Project-Liquid/TheRocket/RegenSolver/README.md

# Regen Solver
This folder contains everything related to the solver developed for the Yale Project Liquid Team. Key files are:
1. <em>hemsolver.ipynb</em> - the main (HEM Model) solver
2. <em>solverscript.py</em> - a python script version of the solver

as well as some additional solver variations (with main differences related to coolant-property definition):

3. <em>subcomprsolver.ipynb</em> - a solver based on the main solver, but using properties for a coolant (using CoolProp) that is in the subcooled liquid state region
4. <em>subsupersolver.ipynb</em> - a solver based on the main solver, but using properties for a coolant (using Cantera) that is in the suberheated vapor state region

The main files to use, however are (1) and (2).

## Regen Solver Usage
There are 2 ways to use the main (HEM model) solver: 

1. the Jupyter Notebook version (hemsolver.ipynb) - a notebook version, which includes all the developed info with all the plots and explanations, but is slower to run (and requires a lot of scrolling).

2. the Python Script version (solverscript.py) - a python script version, that abstractizes all the logic and code of the solver (and is thus more difficult to interpret when starting out), but gives much more flexibility, faster solving and allows for iteration on variables.

The setup for both of these versions is very similar - the main difference is in the reccommended IDE’s used. The following discussion will be only on the Notebook version.

#### Setup
To run the code, one needs to install the following aditional libraries:
- scipy
- CoolProp
- cantera
Our package import looks like this
```
# general
import os
import numpy as np
import pandas as pd

# thermo and prop
import cantera as ct
from CoolProp.CoolProp import PropsSI

# numerical methods
import scipy.optimize

# visualization / other
import matplotlib.pyplot as plt
```

#### Usage

<b>Prereqs:</b>
For the notebook version the recommended IDE is VSCode. Note: to run .ipynb files you will need to install some additional extensions if you don’t already have them. VSCode is nice in that it recommends you these extensions you need, but for safety one you definitely need is the Jupyter extension which you can install by going to Extenstions an finding it in the search bar.

<b>Usage:</b>
To use this version, define your solver input parameters located at the very top and then click the Run All button on the top toolbar. All the results will be outputed and visible by scrolling to the very bottom of the solver notebook.

#### Parameter definition
Parameter definition in <em>hemsolver.ipynb</em> looks as follows:
```
# Define Parameters
def_P0 = 2.758e+6 # [Pa] - first chamber (stagnation) pressure guess 
def_Ti = 300      # [K] - first chamber inlet temperature guess
def_P_ci = 4.5e+6 # [Pa] - coolant inlet pressure
def_X_ci = 0.4 # [-] - coolant inlet quality
def_x_off = 0.024 # [m] - cooling jacket offset
def_T_hw = 1000 # [K] - target hot wall temperature (should be below 1373 K)
def_T_cw = 530 # [K] - target cold wall temperature (should be below 623 K)
def_N_channels = 16 # [-] - number of cooling channels
def_t_rib = 0.005 # [m] thickness of ribs 
def_k_wall = 30 # [W/mK] - thermal conductivity of wall
def_N = 100 # number of nodes
```
Changing any one of these parameters will change the output. More parameters are definable (such as defining target temperatures as piee-wise linear functions), but it is suggested to refer to the solver file itself for explanations on them.

## Some Example Results
Here are examples of plots from the solver. Note that these do not depict the actual potential design, yet they do serve to display the format of the visual outputs of the solver.

<b>Coolant Pressure:</b>
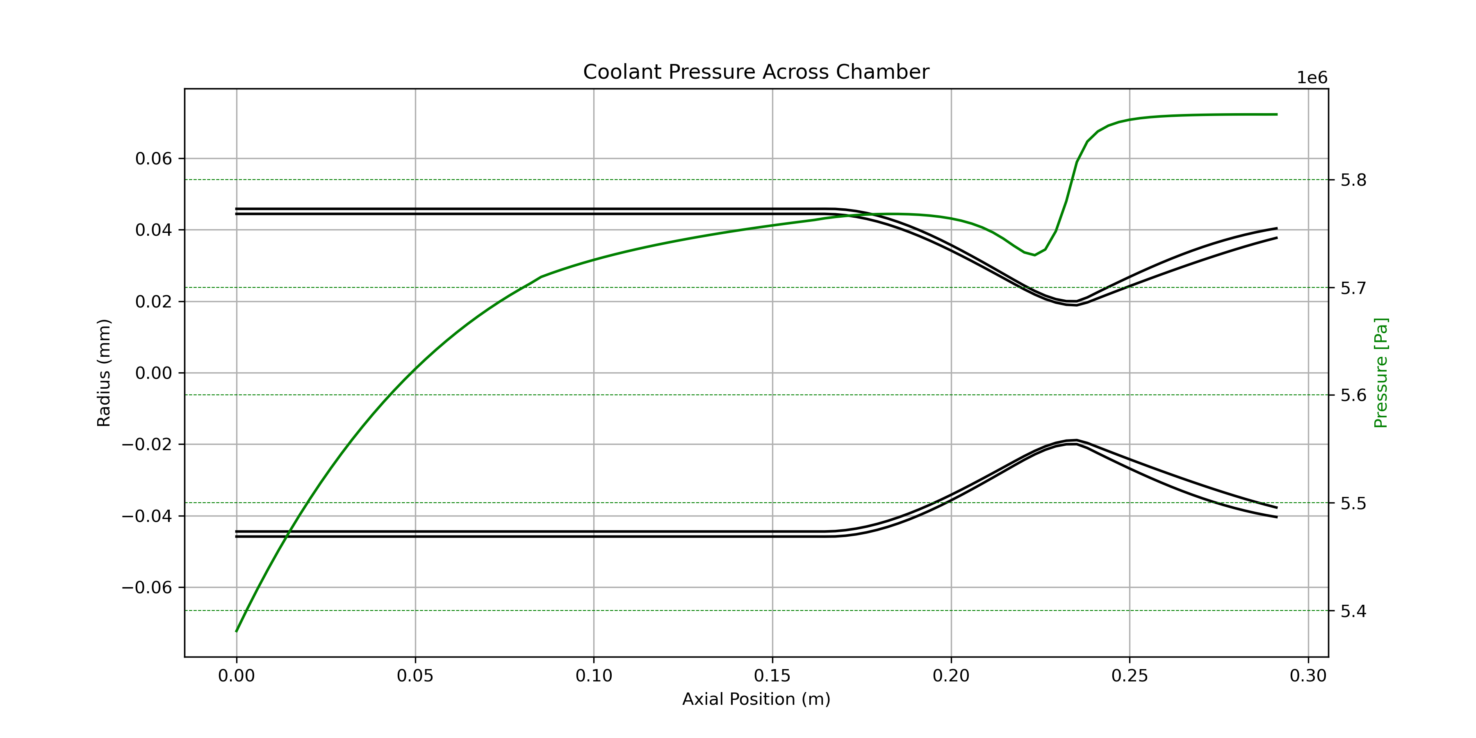
[picture p1: RegenSolver/solverplots/solved/coolantpres.png]
Pressure


<b>Coolant Temperature:</b>
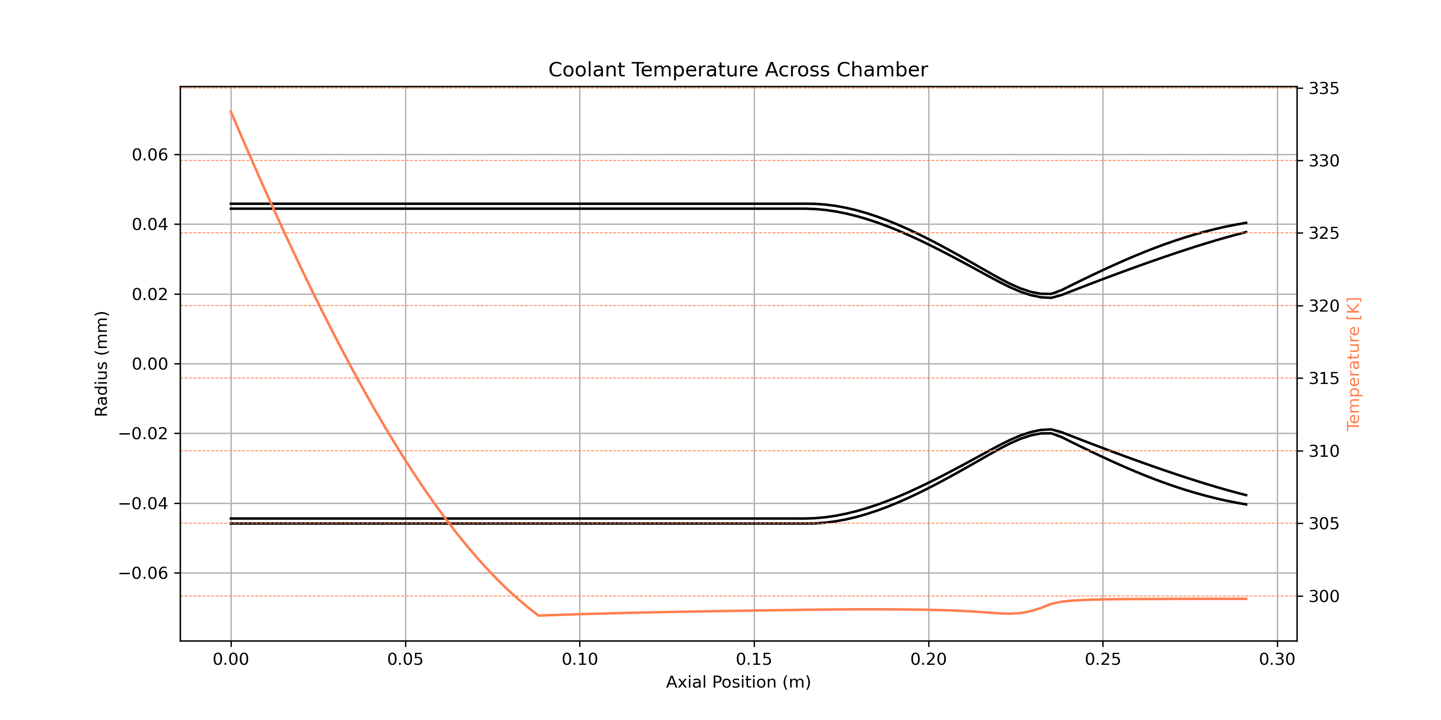
[picture p2: RegenSolver/solverplots/solved/coolanttemp.png]
Temperature


<b>Coolant Velocity:</b>
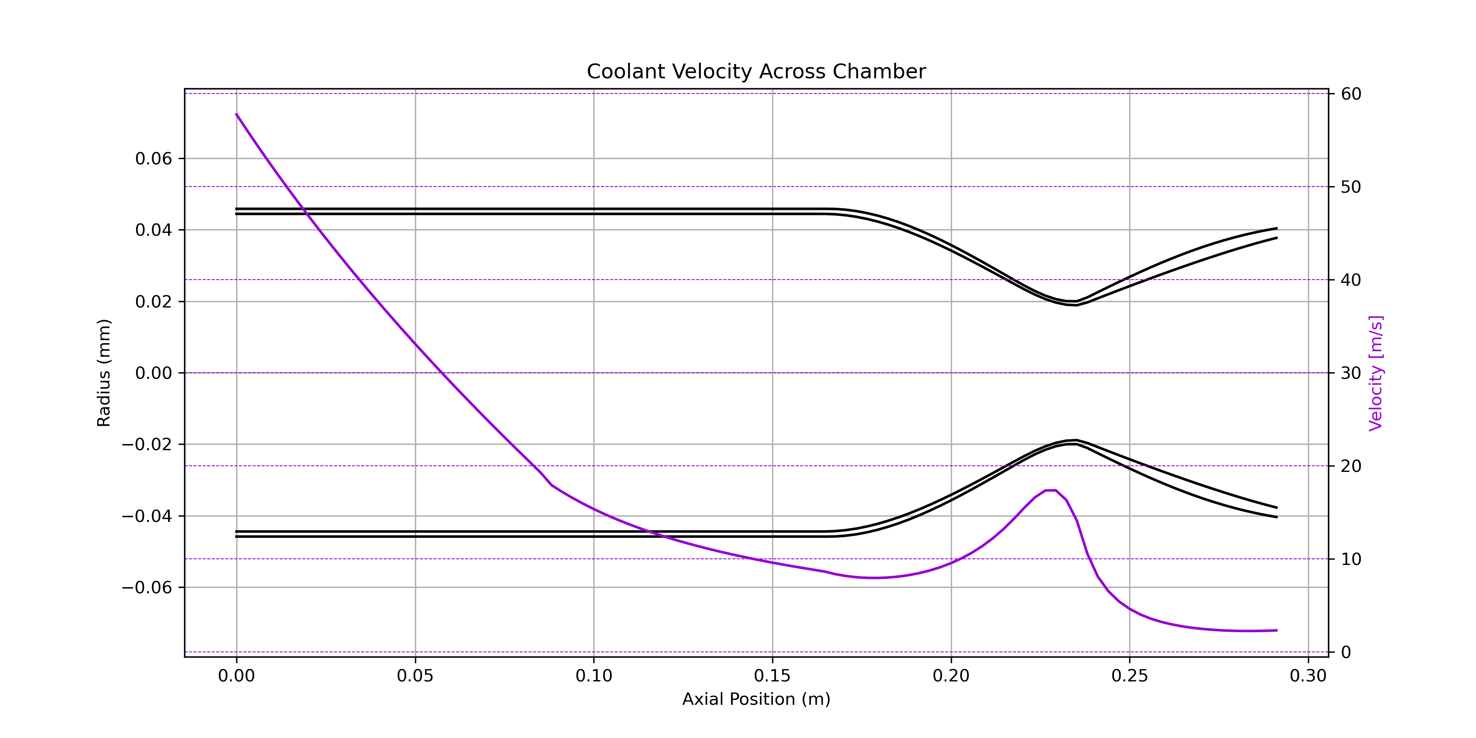
[picture p3: RegenSolver/solverplots/solved/coolantvel.png]
Velocity


<b>Coolant Density:</b>
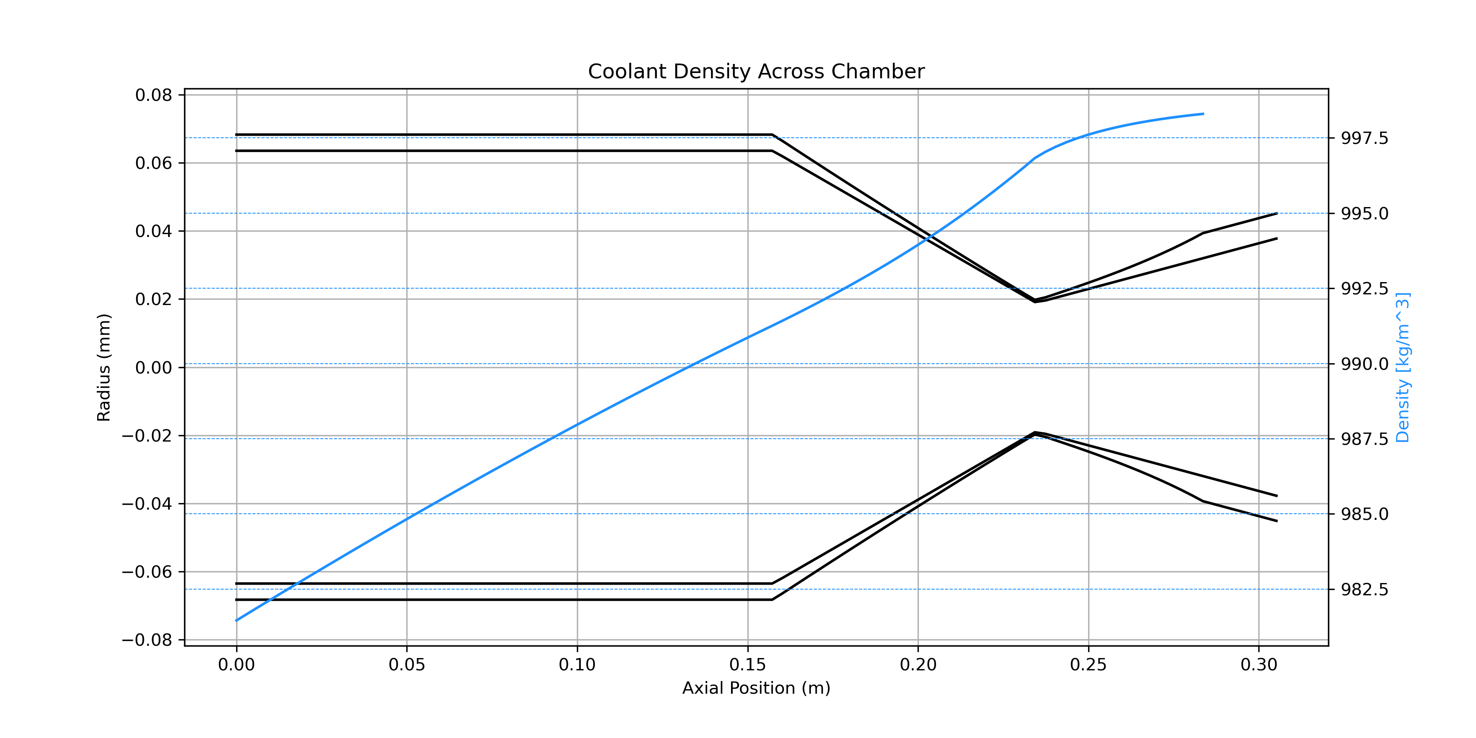
[picture p4: RegenSolver/solverplots/solved/soldens.png]
Density
