Project-Liquid/TheRocket/TheEngine/Thermal Considerations & Film Cooling/Gaseous Boundary Layer Cooling.docx

# Gaseous Boundary Layer Cooling Modeling

Last Updated: 9/12/2022

## Boundary Layer Cooling Principles

Boundary layer cooling is a very simple and effective method of cooling the combustion chamber walls of a rocket. The basic idea is that the freestream working fluid is separated from the wall by the coolant-filled boundary layer. The heat from the working fluid then must convect through the boundary layer, which then in turn convects heat into the chamber wall. As the coolant travels downstream, more and more heat convects into the coolant - so the average temperature throughout the boundary layer increases with axial distance downstream. This, in turn, means that boundary layer cooling is less effective as you go further downstream. Below in figure 1 is a qualitative example of a curve of cooled wall temperature over axial distance.

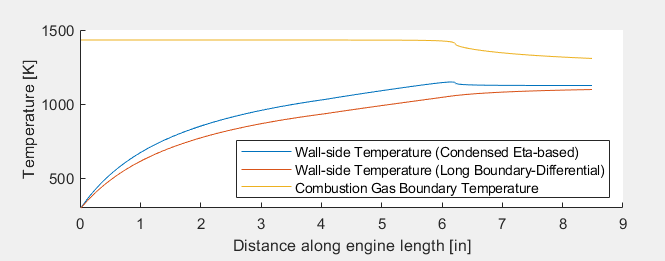
[picture p7: figure]

Figure 1: Qualitative Example of Cooled Wall Temperature vs Axial Distance

When designing a liquid rocket engine, the most important thermal parameter is the heat flow or heat flux into the engine, one of the parameters of which is the temperature of the gas contacting the wall. Therefore, it is critical to determine the wall-side gas temperature, or adiabatic wall temperature, in combination with the heat transfer coefficient (see document [A], heat transfer coefficient section).

## Expanded Numerical Modeling of Wall-Gas Temperature

For the purposes of this project, the boundary layer coolant can be considered a gas upon injection, due primarily to ethane’s high vapor pressure and to a somewhat lesser extent the high freestream temperatures within the combustion chamber. This rather drastically reduces the performance of the boundary layer coolant, but at least makes modeling of the effects of cooling somewhat simpler. An outline of a numerical model can be found in the air force technical report AEDC-TR-91-1 by William Grissom[1].

For this method, certain nomenclatures must be defined. They are listed below:

- G is the freestream mass flow rate per unit area, or mass flux in kg/s-m^2
- K_t is a turbulence correction factor, unitless, where K_t =1+10.2e_t
  - e_t is some scalar turbulence fraction, usually ~0.1
- m_(bl) is the total mass flow rate of the boundary layer at some point per unit circumference of the nozzle at the considered point in kg/s-m
- m_c is the coolant mass flow rate per unit circumference in kg/s-m
- D is instantaneous chamber diameter, in m
- T_(aw) is the adiabatic wall temperature at some axial distance in K
- T_s is the static freestream temperature in K
- T_r is the recovery temperature, or boundary layer side chamber temperature in K

Grissom then outlines step-by-step a method for predicting the adiabatic wall temperature across the length of the nozzle. While they are provided in the form of differential equations (e.g. dM = f(x)dx ), if variables such as, for example, dM are treated as finite values (i.e. treat dM as ΔM ) and broken into many finite step sizes, the problem becomes similar to a higher-order application of Euler’s method. The equations which drive such a model are outlined below.

First, initial conditions must be set, and correction factors calculated. They are as follows:

Initial diameter: D = D_c

Initial circumferential coolant flow rate: MC_c =(m_(BLC))/(πD)

Initial boundary layer flow rate: MC_(bl) =MC_c

Initial wall temperature: T_(aw) =T_0

Molar weight correction factor: K_m =((M_c)/(M_g))^0.14

Turbulence correction factor: K_t =1 + 10.2e_t

Begin at some point of distance L downstream. In this case, we will begin at L = h , where h is the step size, in meters, such that across each step the finite distance dL≈h .

First, calculate the change in diameter at that point. This can be done using downstream distance of the nozzle inlet, or the beginning of the converging section, L_(con) , that of the throat, L^(*) , and that of the end of the nozzle, L_(exit) , as well as the angle of contraction θ_(con) and expansion θ_(exp) . Save the finite stepwise change in diameter as dD as follows:

dD = D_i -D_(i-1) (1)

Then, the discrete value of dx can be calculated where x is the distance parallel to the contour.

dx = √(dL^2 +dr^2)=√(dL^2 +((dD)/2)^2) (2)

Contour distance x is then calculated simply:

x_i = x_(i-1) +dx (3)

Current flow area is calculated using the diameter:

A_i =1/4πD^2 (4)

Freestream mass flux is calculated using the area and given constant freestream mass flow rate:

G_i = (m_(fs))/(A_i) (5)

Freestream mach number is then calculated using methods outlined in the nozzle flow modeling document[B]. Next, the properties of both the coolant and the freestream gas must be retrieved. The only practical way to do so is to use software, preferably Cantera, as outlined in the Quick Reference document[C], after setting the respective gasses to their static conditions. Specifically, the isobaric heat capacity c_p , dynamic viscosity μ , and thermal conductivity k must be obtained for both the coolant gas/fuel and the freestream product gas. Following this, the prandtl number can be calculated as per its definition:

Pr_(fs, i) =(μ_(fs, i) c_(p, fs, i))/(k_(fs, i)) (6)

Pr_(c, i) =(μ_(c, i) c_(p, c, i))/(k_(c, i)) (7)

Next, a second-order Runge-Kutta method is employed to approximate the addition of mass flow rate to the boundary layer from entrainment of the freestream gas in the boundary layer. The finer details of the method will be spared, but the vague framework of the method is that a guess will be made at the change in boundary layer mass flow, after which a new guess will be made based on the first guess, and then the final guess is approximated as the average of the two.

dMC_(bl, fse, i, 1) =0.1963K_t G_i ((μ_(fs, i))/(MC_(bl, i)))^0.25 dx (8)

dMC_(bl, fse, i, 2) =0.1963K_t G_t ((μ_(fs, i))/(MC_(bl, fse, i) +dMC_(bl, fse, i, 1)))^0.25 dx (9)

…noting again that dMC and dx are treated as finite, scalar values for this method, and that equation 9 has the output from equation 8 as a parameter. The actual delta-mass flow is then approximated as an average of the two guesses.

dMC_(bl, fse, i) =(dMC_(bl, fse, i, 1) +dMC_(bl, fse, i, 2))/2 (10)

Next, the change in coolant mass flow per unit circumference due to the changing diameter of the nozzle across axial distance - i.e. the decreasing/increasing circumference - must be calculated. This can be approximated using the following equation:

dMC_(c, D) = -(MC_(bl, i))/(D_i)dD (11)

…with dD again being treated as a finite delta-D. The change in the total boundary layer mass flow rate can then be approximated by simply adding the “delta-MC” terms calculated above, like so:

MC_(bl, i) =MC_(bl, i-1) +dMC_(bl, fse, i) + dMC_(c, D, i) (12)

…and the change in coolant (not total boundary layer) mass flow rate per unit circumference can be approximated by neglecting the free stream gas entrainment:

MC_(c, i) =MC_(c, i-1) +dMC_(c, D, i) (13)

Next, the recovery temperature, or the temperature of the freestream gas after contacting the boundary layer, must be calculated. The recovery temperature is simply a function of the stagnation temperature T_0 (assumed to be essentially equal to chamber temperature as per the chamber modeling document[D]), Prandtl number, and the static temperature T_s as calculated throughout the nozzle in the nozzle modeling document[B].

T_r =T_0 -(1-Pr_(fs) ^(1/3) )(T_0 -T_s ) (14)

Finally, the linearized change in adiabatic wall temperature can be approximated using the provided equation:

dT_(aw, i) = dMC_(fse, i) (Tr-T_(aw, i-1) )(MC_(bl, i) +MC_(c, i) (1/(K_m)*(c_(p, c))/(c_(p, fs))-1))^(-1) (15)

Then, approximating the adiabatic wall temperature at the current step simply becomes:

T_(aw, i) =T_(aw, i-1) +dT_(aw, i) (16)

For the purposes of determining heat flux, the heat transfer coefficient can be calculated as per the thermal loads document[A]. This process then restarts, with the calculated parameters in equations 3-16 becoming the initial conditions for the next step. The process is repeated for each step until the full length of the nozzle has been covered. Note that after the recovery temperature, wall temperature, static pressure[D], etc. are calculated at each point, the fluid properties of the coolant and freestream gas must be re-evaluated - again, preferably using Cantera.

## Single Differential Modeling of Wall-Gas Temperature

The previous purely numerical method can be used to yield marginally more conservative (i.e. higher temperature) estimates of an expected wall temperature, another method is provided by Grissom which appears to yield curves which more closely reflect the effects of changing recovery temperature throughout the nozzle. This method involves a single differential equation describing the behavior of the cooling effectiveness η . The cooling effectiveness is defined simply as…

η=(T_r -T_(aw))/(T_r -T_0) (17)

…or more simply put, the ratio of the difference between the recovery temperature T_r and the wall temperature T_(aw) to the difference between the recovery temperature T_r and the injection temperature T_0 . So, when η=1 , the wall temperature is equal to the injection temperature (i.e. no heat flow from the freestream into the wall), and when η=0 the wall temperature is equal to the recovery temperature (i.e. no cooling).

This method is centered around the following differential equation describing η as a function of contour distance x :

dη= -0.1963K_i *K_T *K_m (c_(p, fs))/(c_(p, c))η^2 (1+(1/(K_m)*(c_(p, c))/(c_(p,) fs)))(1/η-1)^(-1/4) dx (18)

The only difference in the initial conditions and nomenclature are defined as follows:

Initial film cooling effectiveness: η= 1

General correction factor: K_i =(G_i μ_(fs) ^0.25)/(MC_c ^1.25)

Parameters such as D , μ , G , K_t , and K_m can be calculated in the same manner as specified in the above section. dx is calculated as a finite value in the same manner, using equation 2. Recovery temperature T_r is again calculated using equation 14.

Assuming an initial cooling effectiveness of η=1 , equation 18 is then used to calculate some finite dη at each point of axial distance L_i starting at L_(i=1) . The cooling effectiveness at each point i can then be determined using a similar method as equation 16, shown below in equation 19.

η_i =η_(i-1) +dη_i (19)

Once discrete values of η have been obtained, the wall temperature T_(aw) can then be backed out simply by using the definition of boundary layer cooling effectiveness, equation 17.

T_(aw, i) =T_(r, i) -η_i (T_(r, i) -T_0 ) (20)

This method is somewhat computationally simpler to implement, and yields a curve which more closely resembles the experimental data shown in TR-91-1[1], but can be more optimistic in its predictions of the effectiveness of film cooling, albeit to a very small degree. As with the expanded method, the coolant ideal gas properties such as density and viscosity need to be recalculated at the calculated static pressures and wall temperatures/recovery temperatures.

Comparisons of these two methods indicate that the predicted wall temperature does not differ significantly until the flow reaches the expanding section of the nozzle, after which the temperature predicted by the single-equation method decreases very slightly below that of the expanded method. Determining which method is more accurate to experimental results, however, requires testing of the rocket engine itself for comparison to theoretical data.

## References and Sources

[1] Grissom BL Cooling (https://drive.google.com/file/d/1sblwUi_BpPOf-dg0ytU-u0OWHGKqjmZC/view?usp=sharing)

## Related Documentation

[A] Thermal Considerations and Loads (https://docs.google.com/document/d/1homPFQnGbIEBKH1nYHeWbC9jdXok5Kiczb4tmeqo9O4/edit#)

[B] Nozzle Flow Modeling (https://docs.google.com/document/d/16WyGRw5Ikb9o1UvMvrIiOay80P_ZhJnjGX2SzdEGsrk/edit?usp=sharing)

[C] Cantera Quick Reference (https://docs.google.com/document/d/1qyf48IUYjvoWwlnIdurIilh9O9bYv-0zfA_flUvgOP8/edit?usp=sharing)

[D] Chamber Flow Modeling (https://docs.google.com/document/d/1jLYpAgBIF4DAZvxFLMegq2dOw-f8xS7uXNU71RqToM4/edit)
