Project-Liquid/TheRocket/TheEngine/Thermochemistry/Basics of Combustion.docx

# Principles of Nitrous Oxide-Ethane Combustion

Last Updated: 2/16/2022

## Perfect Combustion Reaction of Nitrous Oxide and Ethane

Not accounting for chemical equilibrium in imperfect combustion, the perfect combustion formula for nitrous oxide and ethane is expressed as the following formula:

2C_2 H_6 + 14N_2 O → 4CO_2 + 6H_2 O + 14N_2

Using this formula and the second chapter of An Introduction to Combustion[1] (pages 9-27) a value of temperature increase ΔT can be retrieved using the thermochemical properties available from either the CoolProp MATLAB wrapper[A] or the thermochemical tables available at the end of Intro to Combustion.

## Enthalpy of Reaction

To summarize the Enthalpy of Combustion section of Chapter 2[1], the heat of reaction (or ΔH_(rxn) ) can be expressed in the general form:

ΔH_(rxn) =ΣΔH_(f,reac) -ΣΔH_(f,prod) (1)

Where:

- ΔH is the total change in enthalpy for the given amount of products and reactants in moles

- ΔH_(f,reac) is the molar standard enthalpy of formation of the reactants

- ΔH_(f,prod) is the molar standard enthalpy of formation of the products

From this, the exhaust molar specific change in enthalpy Δh can be expressed generally as

Δh = (ΔH_(rxn))/(Σ(N_i MW_i )) (2)

Where:

- N_i is the stoichiometric coefficient of an exhaust product i

- MW_i is the molar weight in kg/mol of an exhaust product i

For our perfect combustion formula of ethane and nitrous oxide, these two equations become:

ΔH_(rxn, NOE) =ΣΔH_(f,reac) -ΣΔH_(f,prod)

= 2(ΔH_(f,Eth) ) + 14(ΔH_(f,N2O) ) - 4(ΔH_(f,CO2) ) -6(ΔH_(f,H2O) ) -14(ΔH_(f,N2) ) (3)

Note that ΔH_(f,N2) is 0 since it is a diatomic gas

## Adiabatic Flame Temperature

The generalized form for ΔT for a given ΔH_(rxn) is as follows:

ΔH =C_(p,ex) ΔT (4)

Where:

- ΔH is the change in gas enthalpy due to the reaction

- C_p is the total heat capacity of the exhaust products

- ΔT is the change in temperature from the initial to final temperature

Note that the value of C_(p,ex) must be obtained as C_p =ΣN_i c_(p,i) , or the sum of the stoichiometric coefficient of each species times its respective molar specific heat capacity at the approximate midpoint of between the initial temperature T0 and final temperature Tf. For our purposes, this Tmid can be assumed to be around 1500K ([1], pg 33).

So, expressing in terms of T_0 and T_f and the perfect N2O-Ethane combustion reaction:

T_f -T_0 = (ΔH_(cmb))/(C_(p,ex)) (5)

For perfect combustion like this, the enthalpy of combustion ΔH_(cmb) is assumed to be roughly equal to the enthalpy of reaction ΔH_(rxn) . Plugging in Equation 4 for ΔH_(cmb) and expressing c_p as a molar weighted fraction of the c_(p,i) of each product yields:

T_f =T_0 + (2(ΔH_(f,Eth) ) + 14(ΔH_(f,N2O) ) - 4(ΔH_(f,CO2) ) -6(ΔH_(f,H2O) ))/(4(c_(p,CO2) ) + 6(c_(p,H2O) ) + 14(c_(p,N2) )) (6)

Pulling the enthalpies of formation from the Intro to Combustion appendix and getting the c_p of each species from CoolProp in MATLAB allows for the calculation of a perfect adiabatic flame temperature of a stoichiometric mixture (a theoretical maximum temperature).

## Flame Temperature with an Excess Propellant

The stoichiometric adiabatic flame temperature tends to be quite high - high enough to melt the engine or subject it to undue thermal stress (bar extreme cooling measures). So, our engine will be running fuel rich - more fuel will be injected into the combustion chamber than can be combusted by the amount of oxidizer available in the combustion chamber. This means that, again neglecting minor reaction products, the fuel will remain uncombusted and absorb some excess heat.

Typically, the mix ratio of fuel is given in terms of mass, usually the variable r, where r = (m^(∙) _(ox))/(m^(∙) _(fuel)) . For these purposes, however, a molar mix ratio r is ideal. This can be found using the ratio r=r(MW_(fu))/(MW_(ox))=(M_(ox))/(M_(fu)) .

Assuming that we will be running fuel rich under pretty much any circumstance (because running ox rich would cause the excess oxidizer to react with the steel in the engine), the combustion reaction can then be expressed as:

(14/r)C_2 H_6 + 14N_2 O → 4CO_2 + 6H_2 O + 14N_2 +(14/r-2)C_2 H_6

…where r≤7

In this case, the nitrous oxide can be assumed to be a constant since we’re assuming there will be excess fuel varying with a mixture ratio less than the stoichiometric mix ratio.

Plugging this new reaction back into Equation 6 yields:

T_f =T_0 + ((14/r)(ΔH_(f,Eth) ) + 14(ΔH_(f,N2O) ) - 4(ΔH_(f,CO2) ) -6(ΔH_(f,H2O) )-(14/r-2)(ΔH_(f,Eth) ))/(4(c_(p,CO2) ) + 6(c_(p,H2O) ) + 14(c_(p,N2) )+(14/r-2)(c_(p,C2H6) )) (7)

Again, assuming perfect combustion, this will allow for the calculation of adiabatic flame temperature as a continuous function of the molar mix ratio r up to a stoichiometric mix ratio of r=7 .

## Enthalpy of Vaporization

For any liquid at a given pressure, there is a certain amount of enthalpy (energy “input”) required to boil the liquid into a vapor. This enthalpy is referred to as the “enthalpy of vaporization”. This value is most often expressed in molar specific terms ( h_(vap) ) or mass specific terms ( h_(vap) ). In other words, h_(vap) is the amount of enthalpy required to vaporize a mole of water already at saturation pressure and temperature.

Most gasses in our exhaust products do not need to account for enthalpy absorbed by vaporization - water, however, may initially form as a liquid and absorb enthalpy until it becomes steam.

Assuming different levels of water vaporization immediately after combustion produces two possible values of heat produced: the “upper heating value”, in which it is assumed that no enthalpy is absorbed by water vaporization (i.e. ΣΔH = ΔH_(rxn) ), and the “lower heating value”, in which it is assumed that all the water absorbs all the theoretically possible enthalpy produced by vaporization. The lower heating value can be acquired by simply subtracting the number of moles of water times the molar specific enthalpy of vaporization of water at the given pressure (which can be retrieved from CoolProp), as in Equation 8.

ΔH_(low) =ΔH_(cmb) -N_(H2O) h_(H2O) (8)

In this case, for caution’s sake, we will be using the upper heating value to provide a worst-case estimate of the combustion temperature. Building an engine around an estimate of the temperature that is higher than the actual experimental temperature is safer than building one around a lower temperature

## Other Vaporization Considerations

Water is not the only fluid in this reaction which is expected to change phases. Both liquid propellants are stored relatively near their vapor pressure for our purposes, and once injected and subjected to the heat of the gas in the combustion chamber, will evaporate and absorb some amount of enthalpy. This means that regardless of our heating value, our propellants will evaporate and effectively lower our total enthalpy of reaction. Note that just as the molar enthalpy of vaporization of water can be found using CoolProp for water, so too can the enthalpy of vaporization be found for nitrous oxide and ethane.

Since in this case we are modeling combustion using a chemical formula, the enthalpy of combustion using the upper heating value including vaporization effects can be written as Equation 9.

ΔH_(cmb, high) = ΔH_(rxn) -N_(Nts) Δh_(vap,Nts) - N_(Eth) Δh_(vap,Eth) (9)

…and the enthalpy of combustion using the lower heating value can be expressed as in Equation 10.

ΔH_(cmb, high) = ΔH_(rxn) -N_(Nts) Δh_(vap,Nts) - N_(Eth) Δh_(vap,Eth) - N_(H2O) Δh_(vap,H2O) (10)

## References and Sources

[1] Introduction to Combustion (https://drive.google.com/file/d/1V93_c_ekuT-lM256LfNEVRspmNPMu8Vh/view?usp=sharing)

## Related Documentation

[A] CoolProp Quick Reference (https://docs.google.com/document/d/1SwY_JbAcMK3dY37hVzANKK0KHyNtMjkAvfUAsUOoy1Y/edit?usp=sharing)
