Project-Liquid/TheRocket/RegenSolver/canteraplots/canteravscoolprop.png

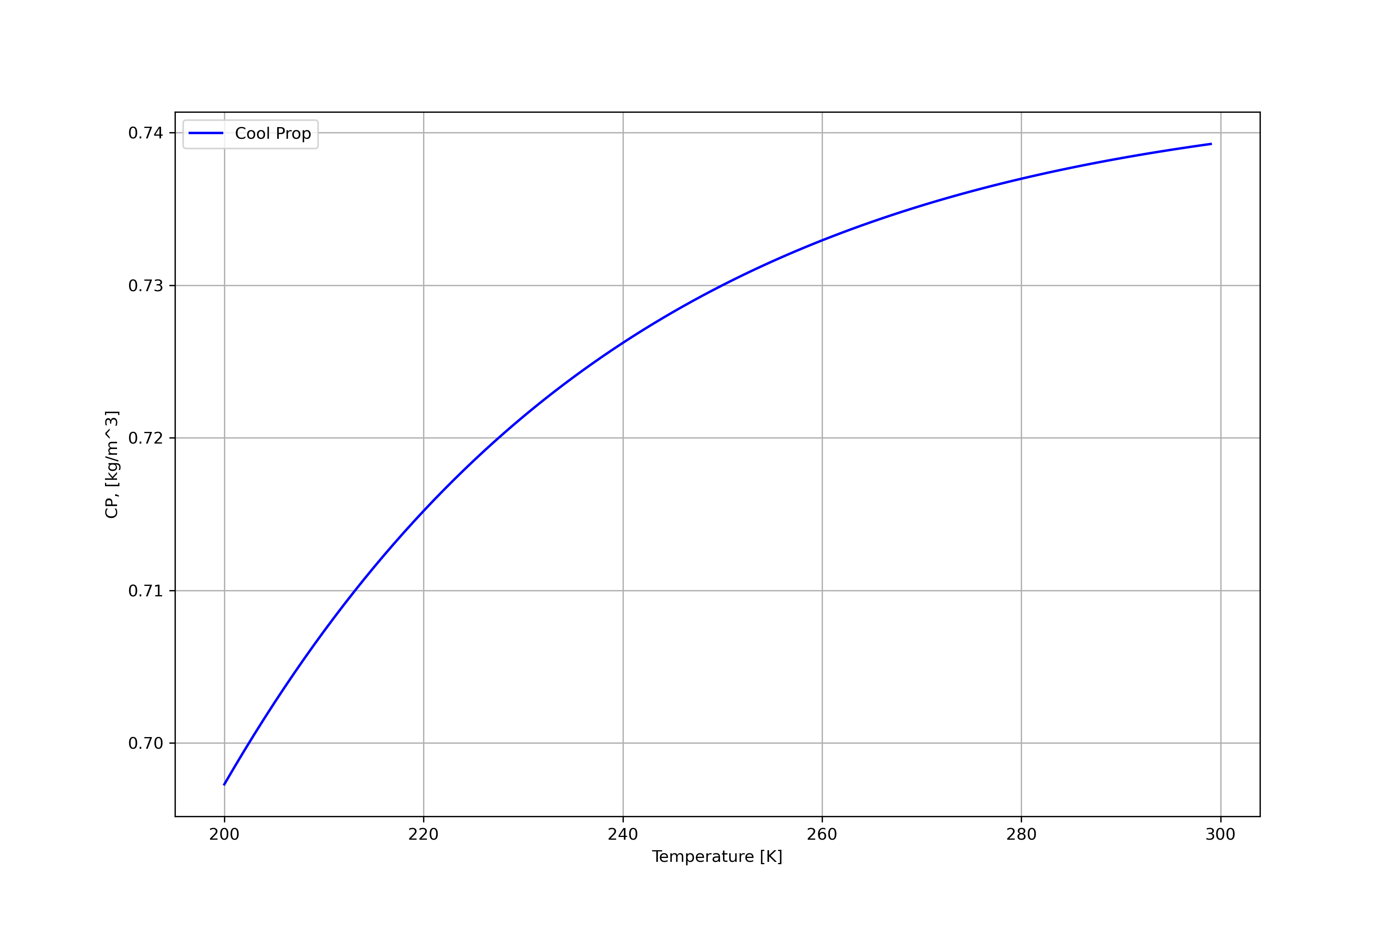
RegenSolver/canteraplots/canteravscoolprop.png
