Project-Liquid/TheRocket/RegenSolver/canteraplots/TvsOF.png

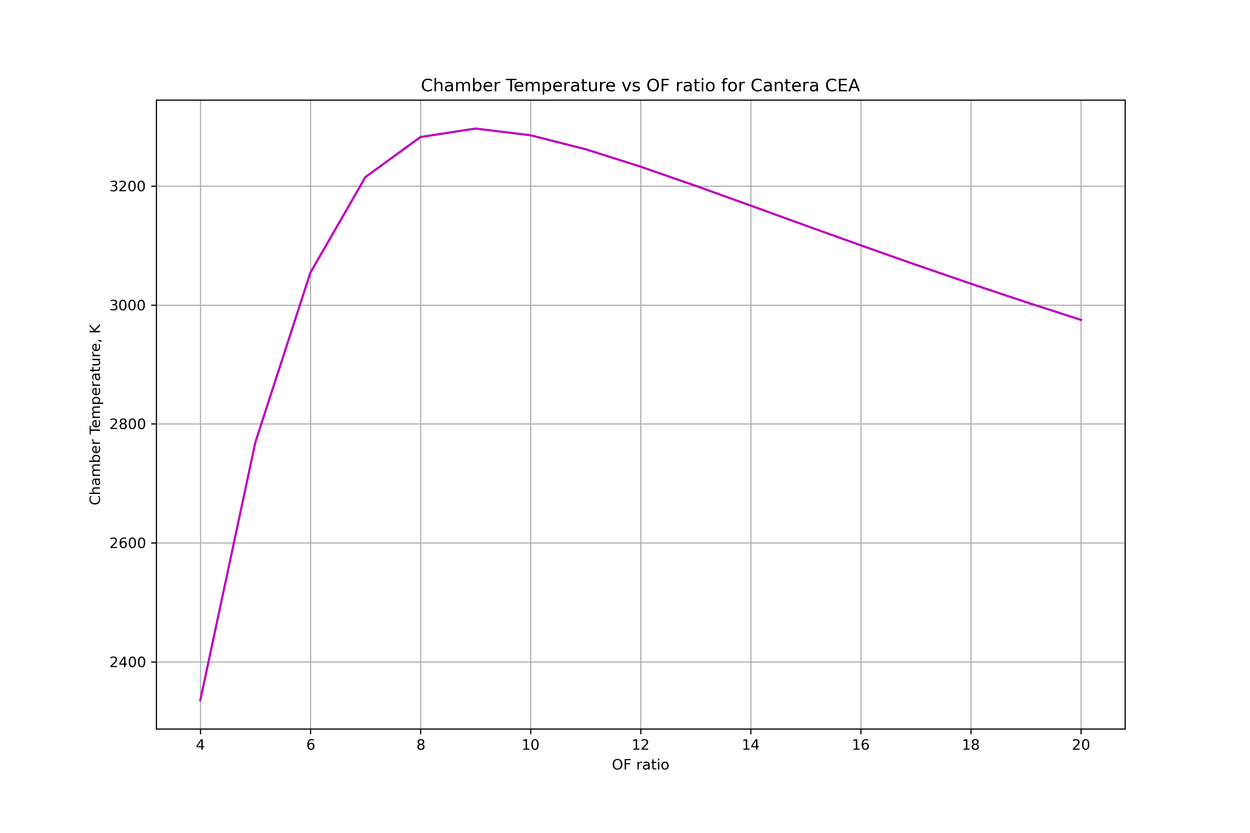
RegenSolver/canteraplots/TvsOF.png
