Project-Liquid/TheRocket/RegenSolver/engineplots/canteraenginegeometry.png

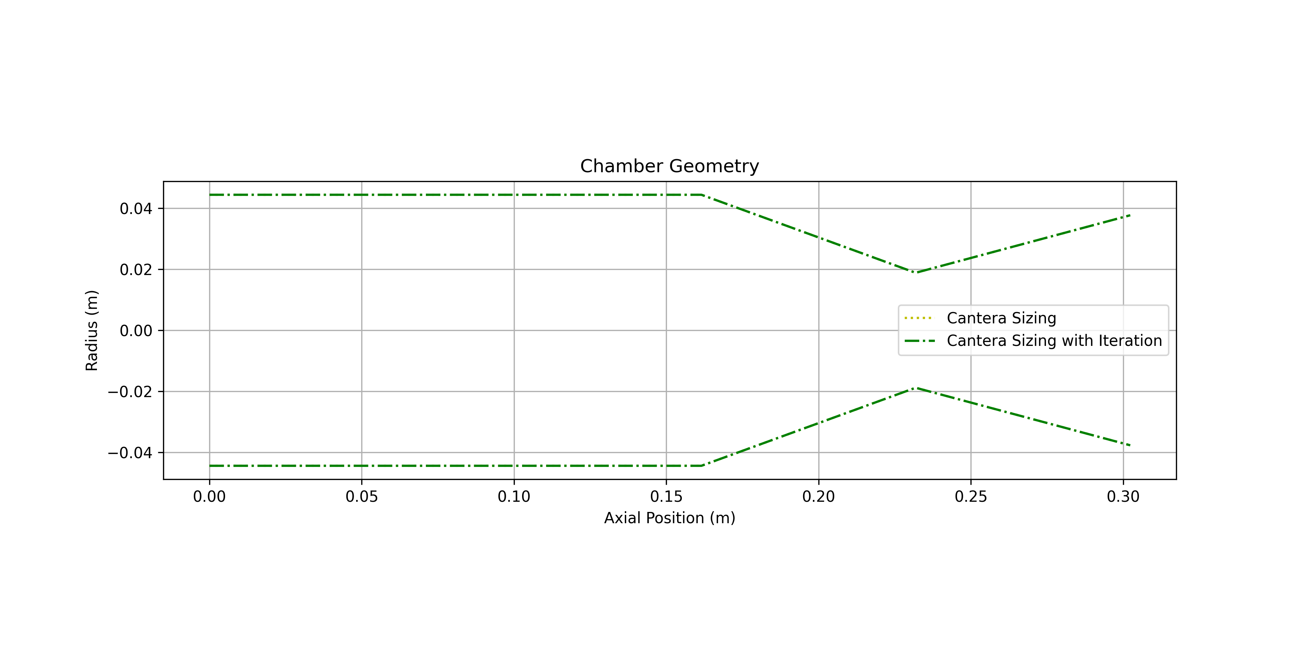
RegenSolver/engineplots/canteraenginegeometry.png
