Project-Liquid/TheRocket/RegenSolver/engineplots/enginegeometry.png

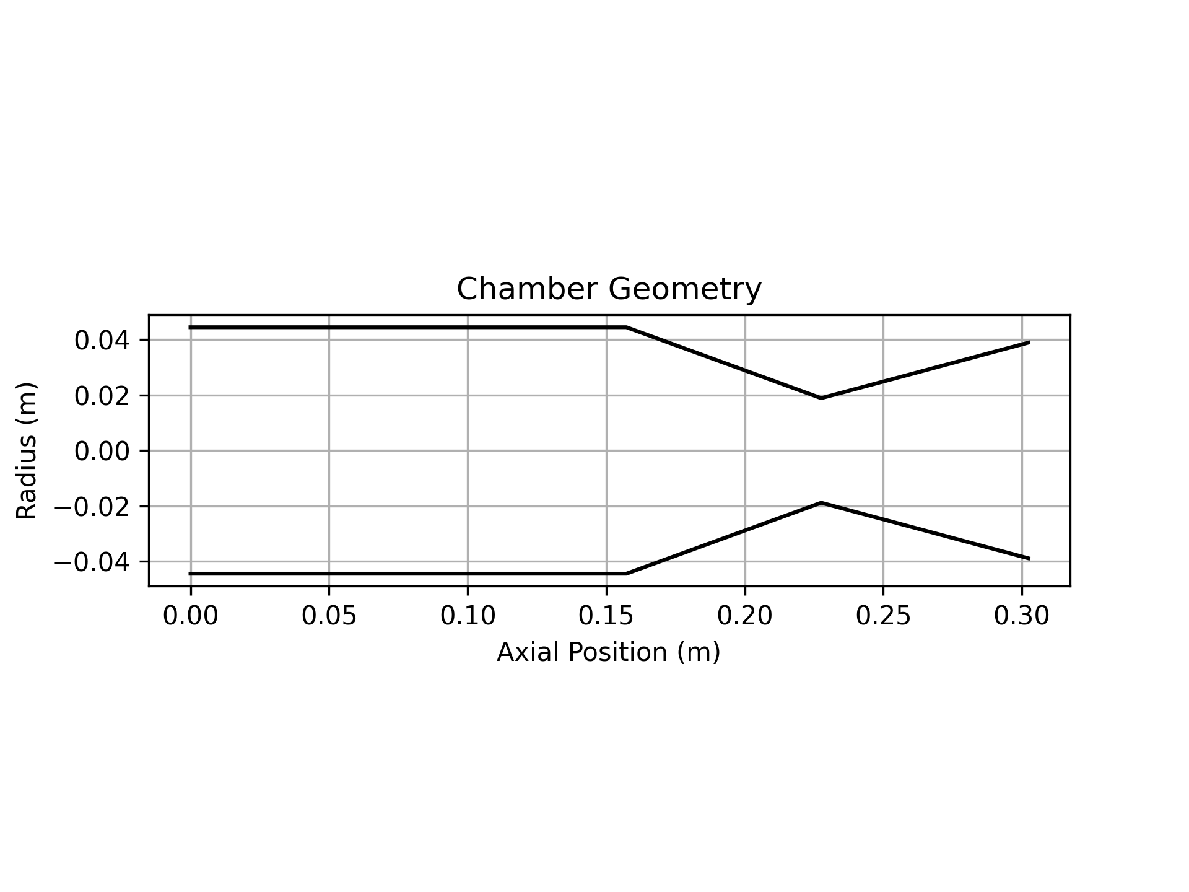
RegenSolver/engineplots/enginegeometry.png
