Project-Liquid/TheRocket/RegenSolver/solverplots/analysis/densityvsX_ci.png

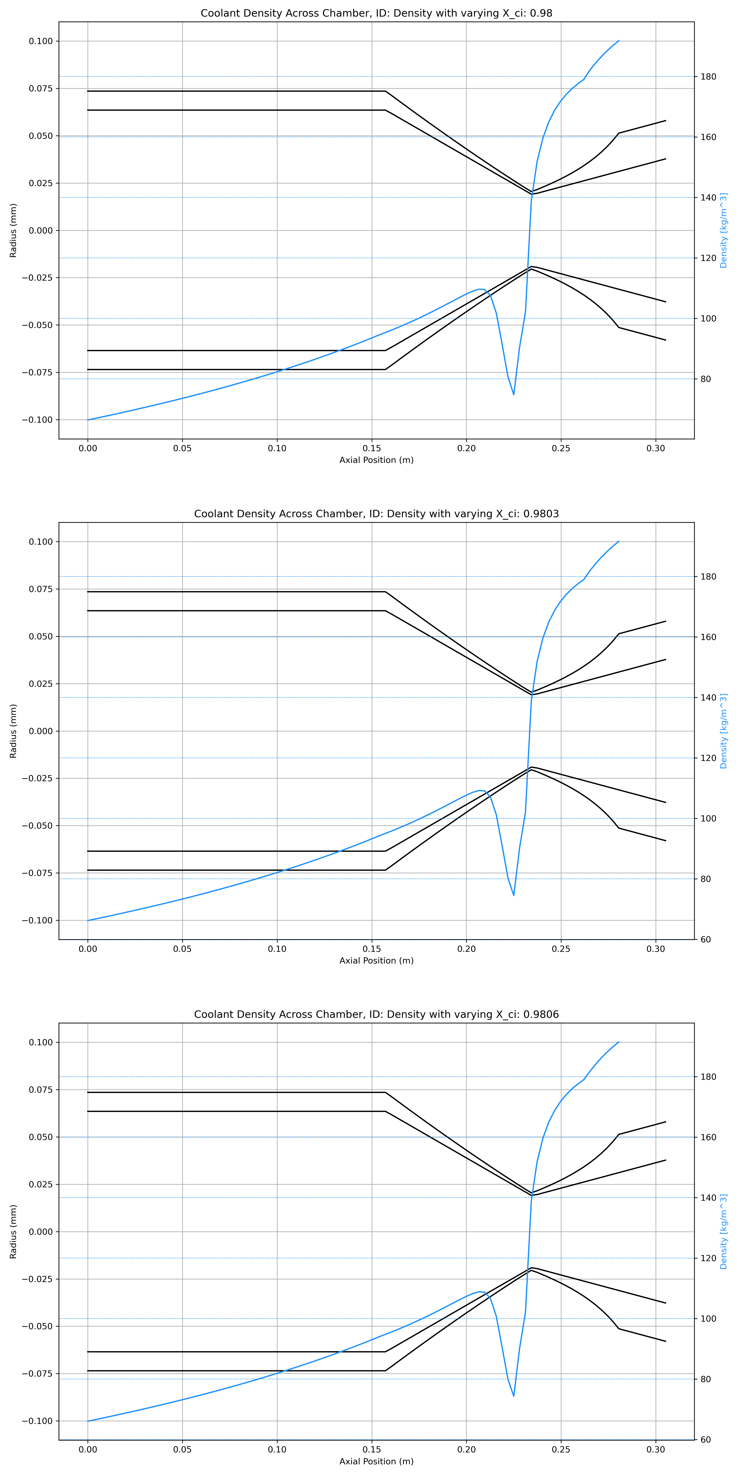
RegenSolver/solverplots/analysis/densityvsX_ci.png
