Project-Liquid/TheRocket/RegenSolver/solverplots/analysis/jacketvsN_chan.png

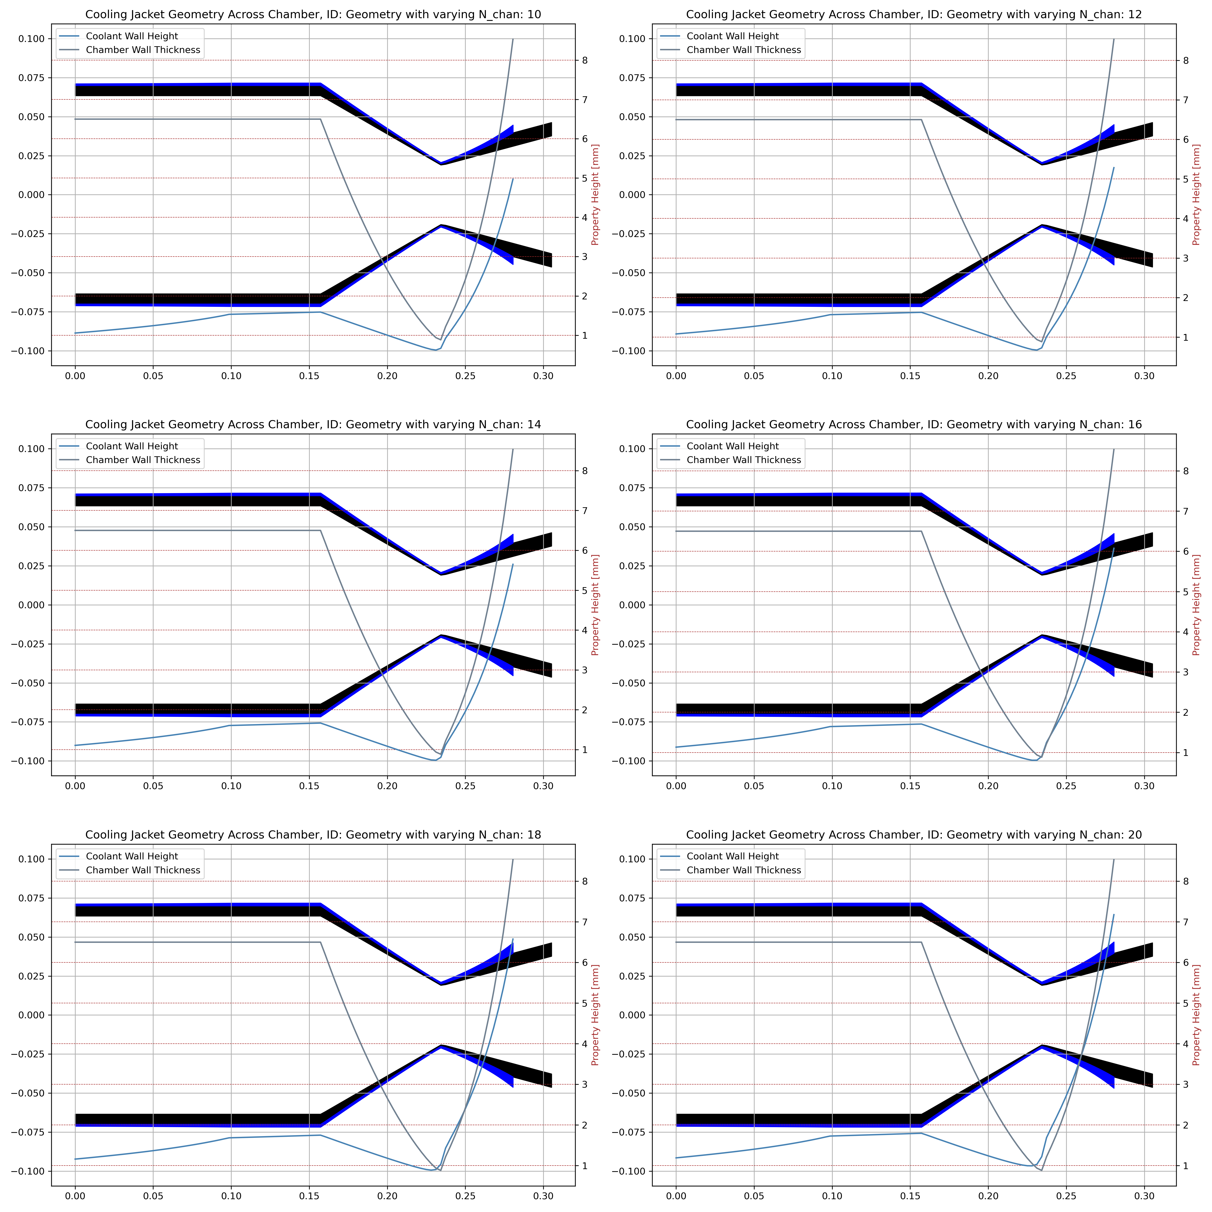
RegenSolver/solverplots/analysis/jacketvsN_chan.png
