Project-Liquid/TheRocket/RegenSolver/solverplots/analysis/jacketvsT_cw.png

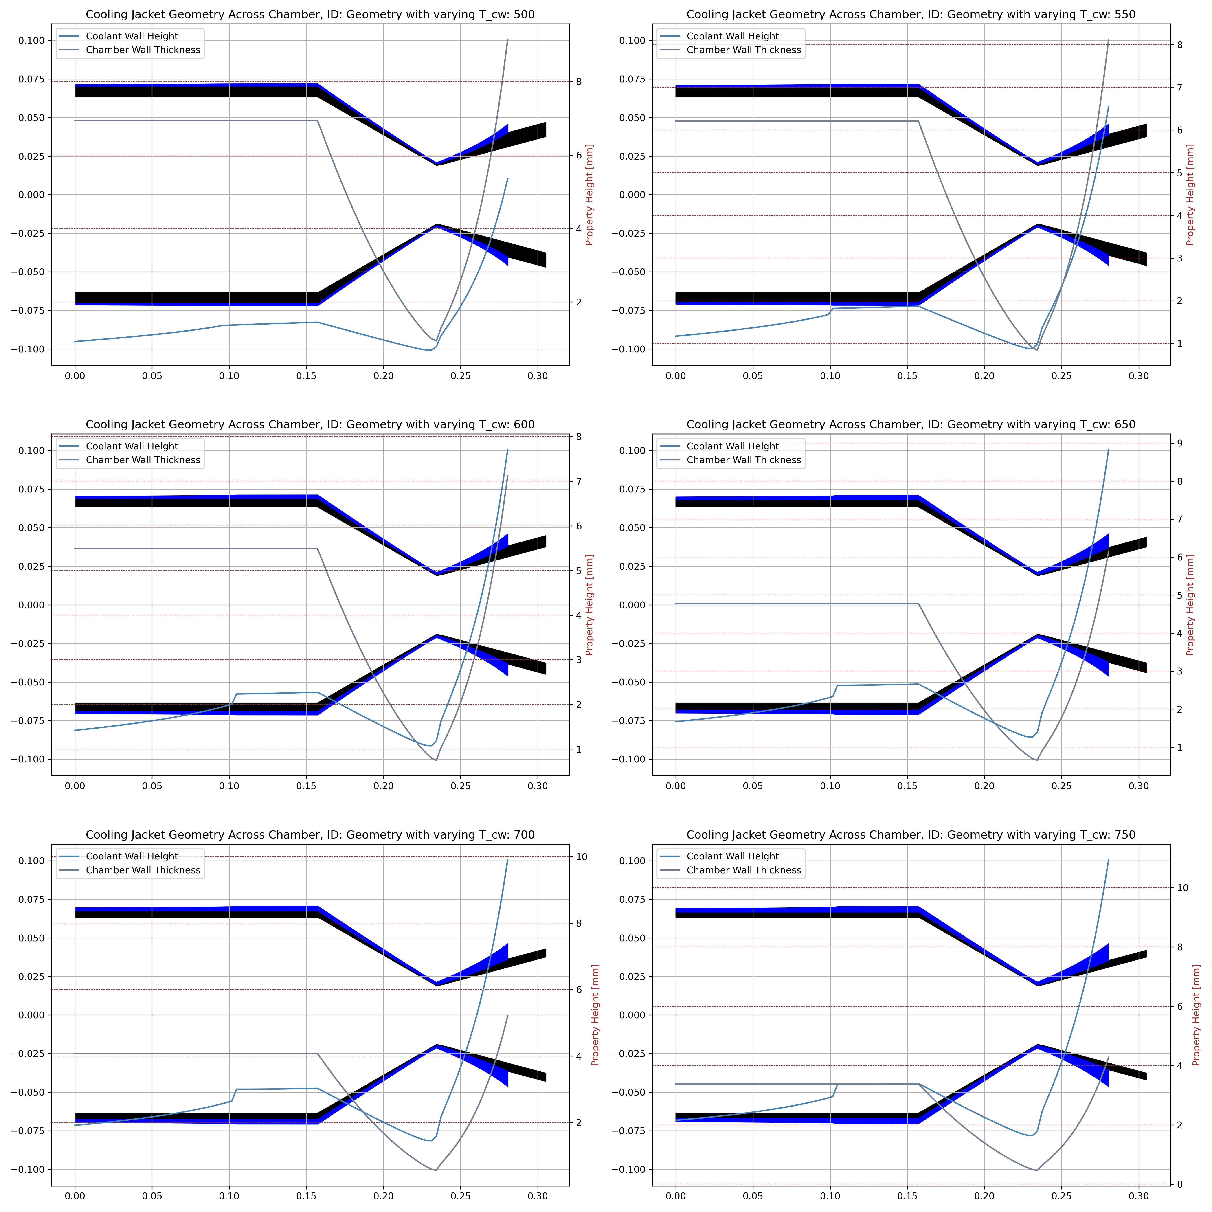
RegenSolver/solverplots/analysis/jacketvsT_cw.png
