Project-Liquid/TheRocket/RegenSolver/solverplots/analysis/jacketvsT_hw.png

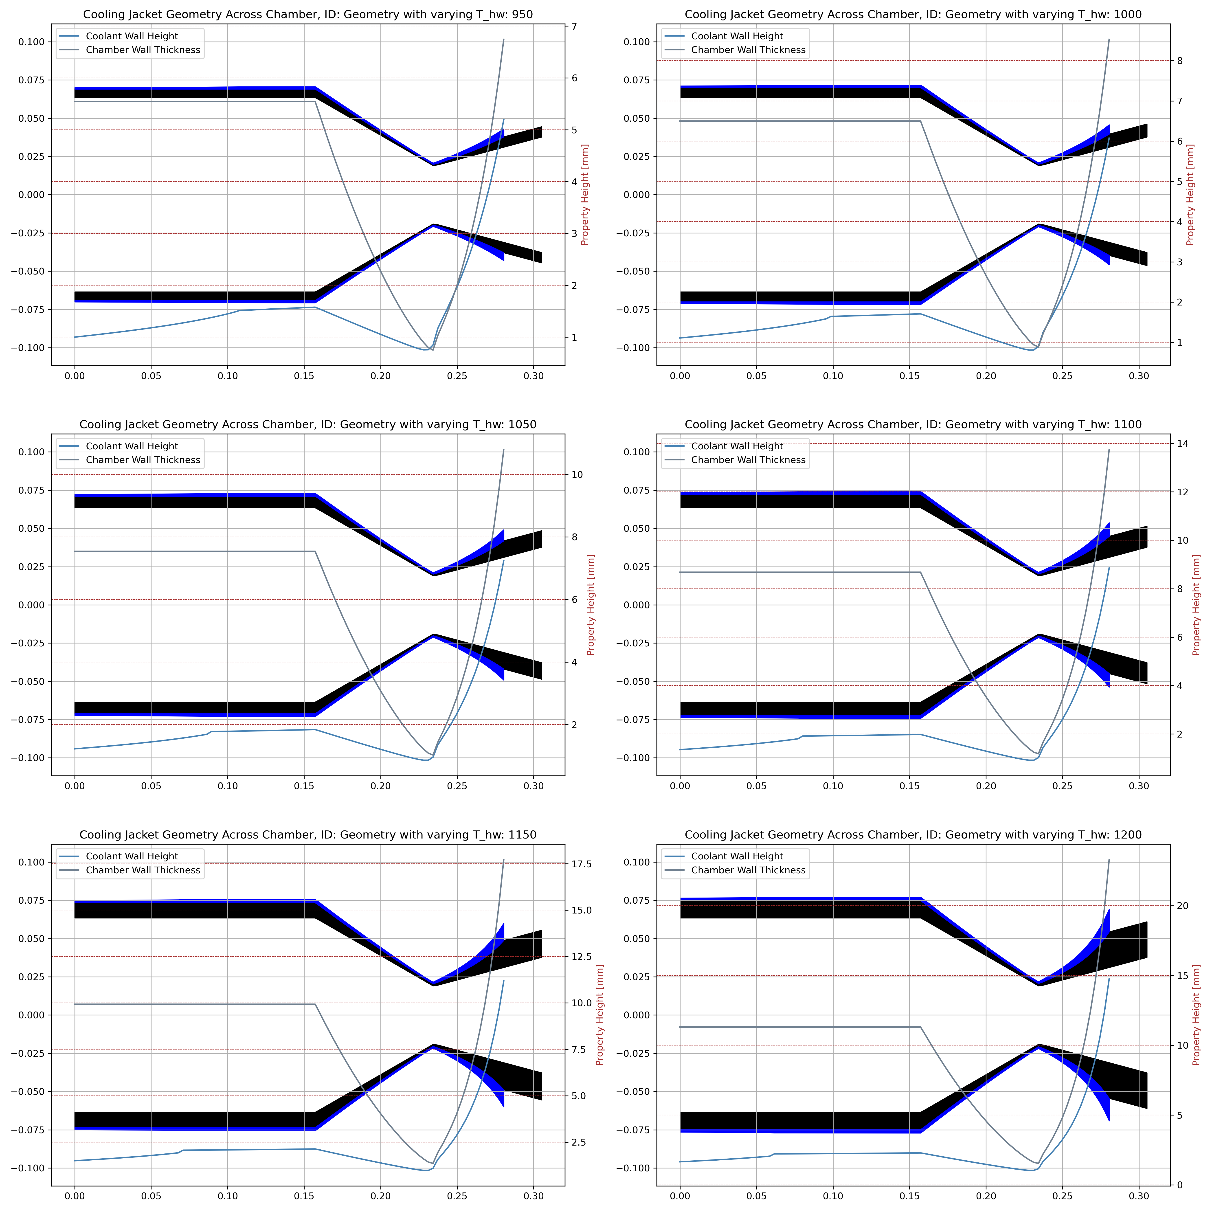
RegenSolver/solverplots/analysis/jacketvsT_hw.png
