Project-Liquid/TheRocket/RegenSolver/solverplots/analysis/jacketvsx_off.png

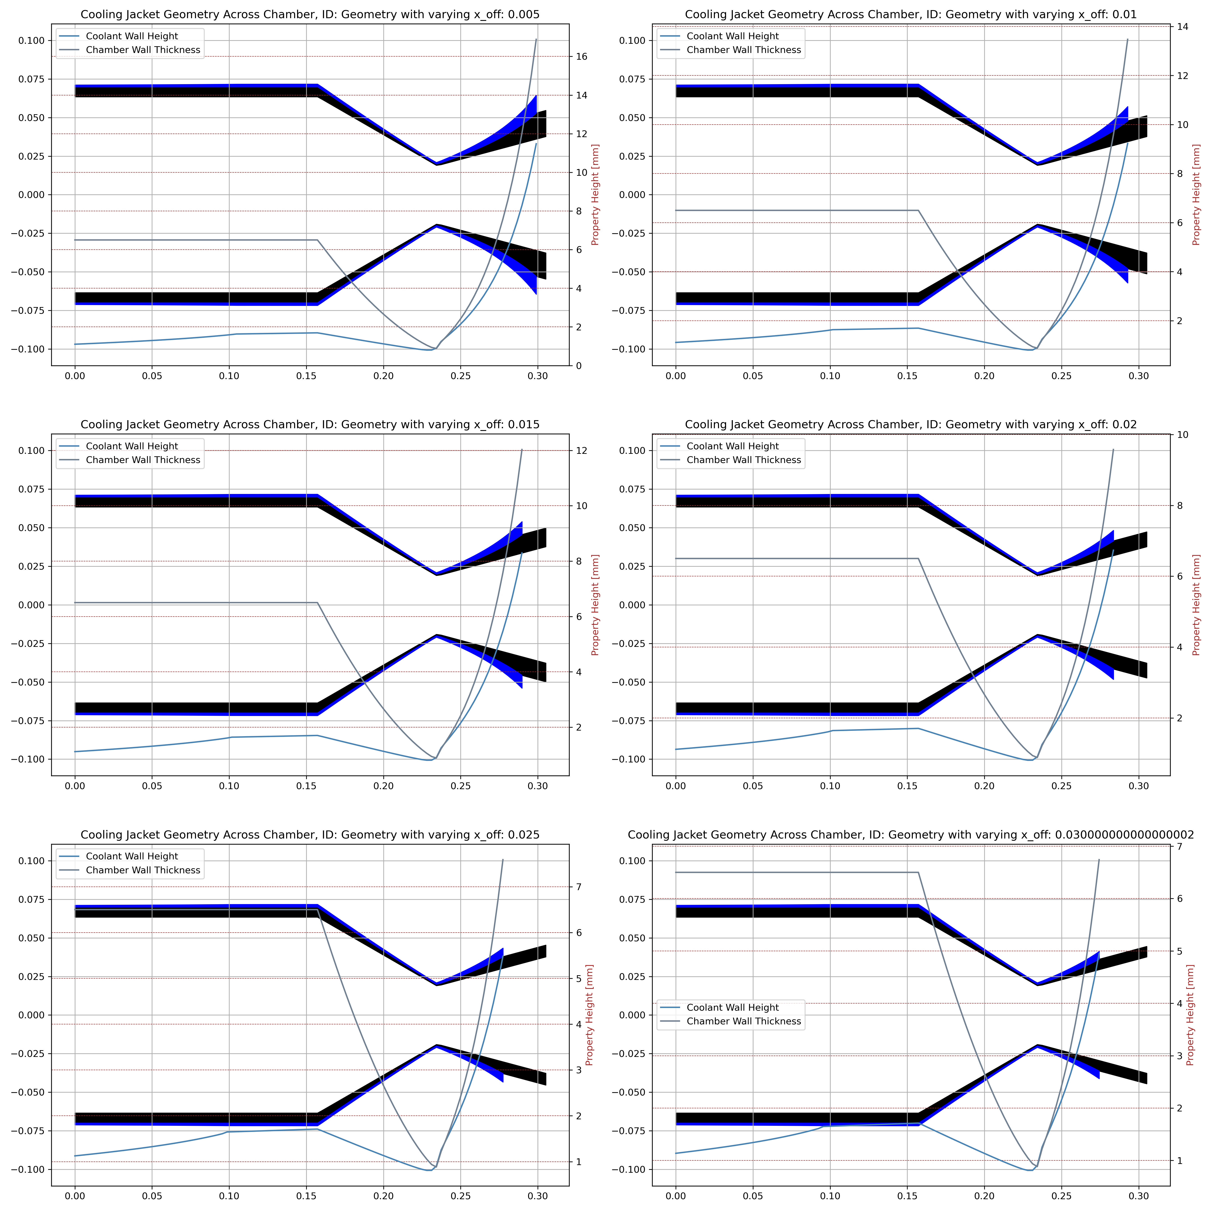
RegenSolver/solverplots/analysis/jacketvsx_off.png
