Project-Liquid/TheRocket/RegenSolver/solverplots/analysis/pressuredropvsX_ci.png

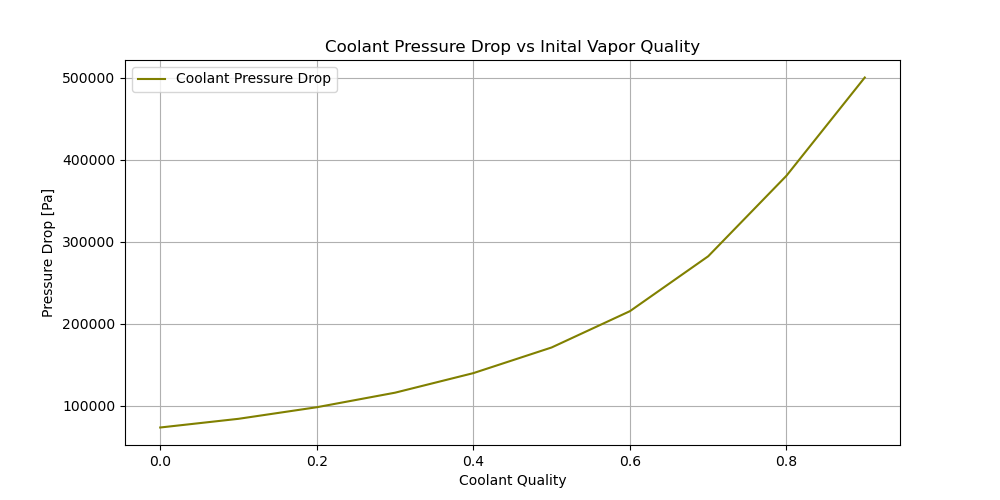
RegenSolver/solverplots/analysis/pressuredropvsX_ci.png
