Project-Liquid/TheRocket/RegenSolver/solverplots/analysis/pressurevsX_ci.png

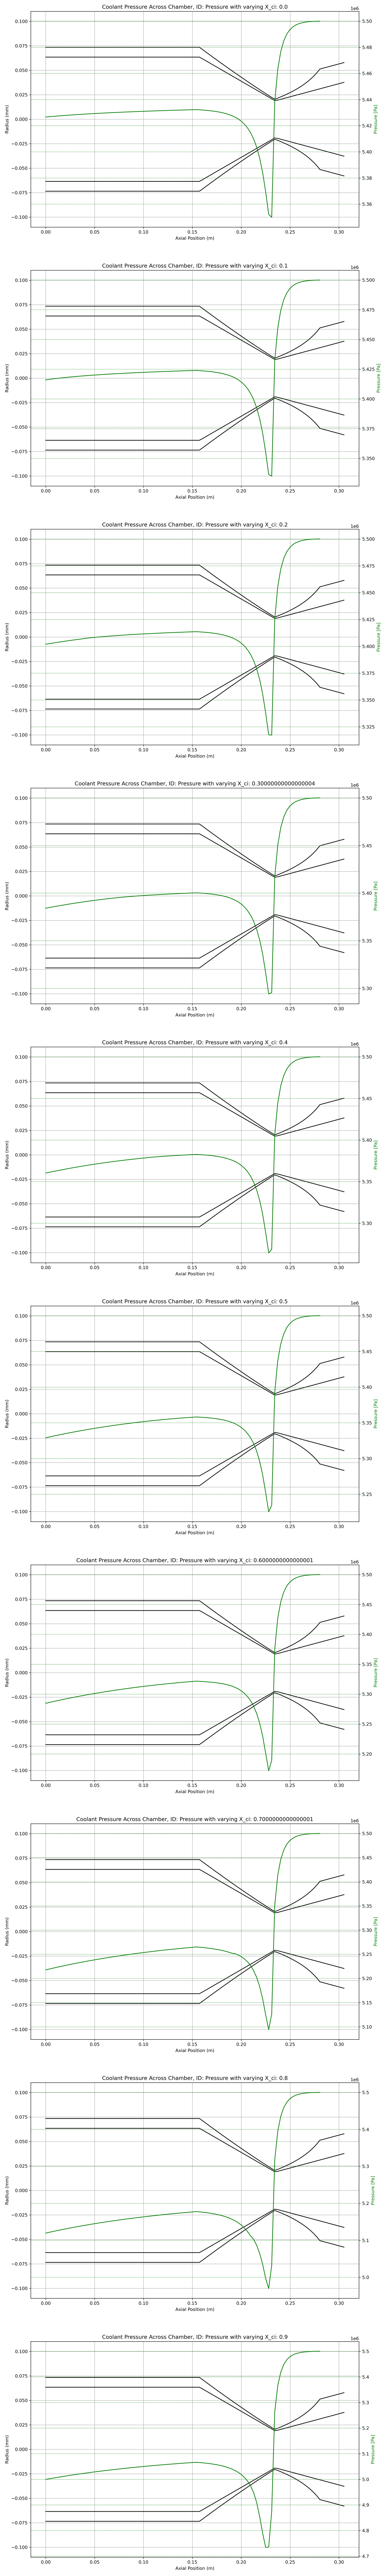
RegenSolver/solverplots/analysis/pressurevsX_ci.png
