Project-Liquid/TheRocket/RegenSolver/solverplots/analysis/presvsP_ci.png

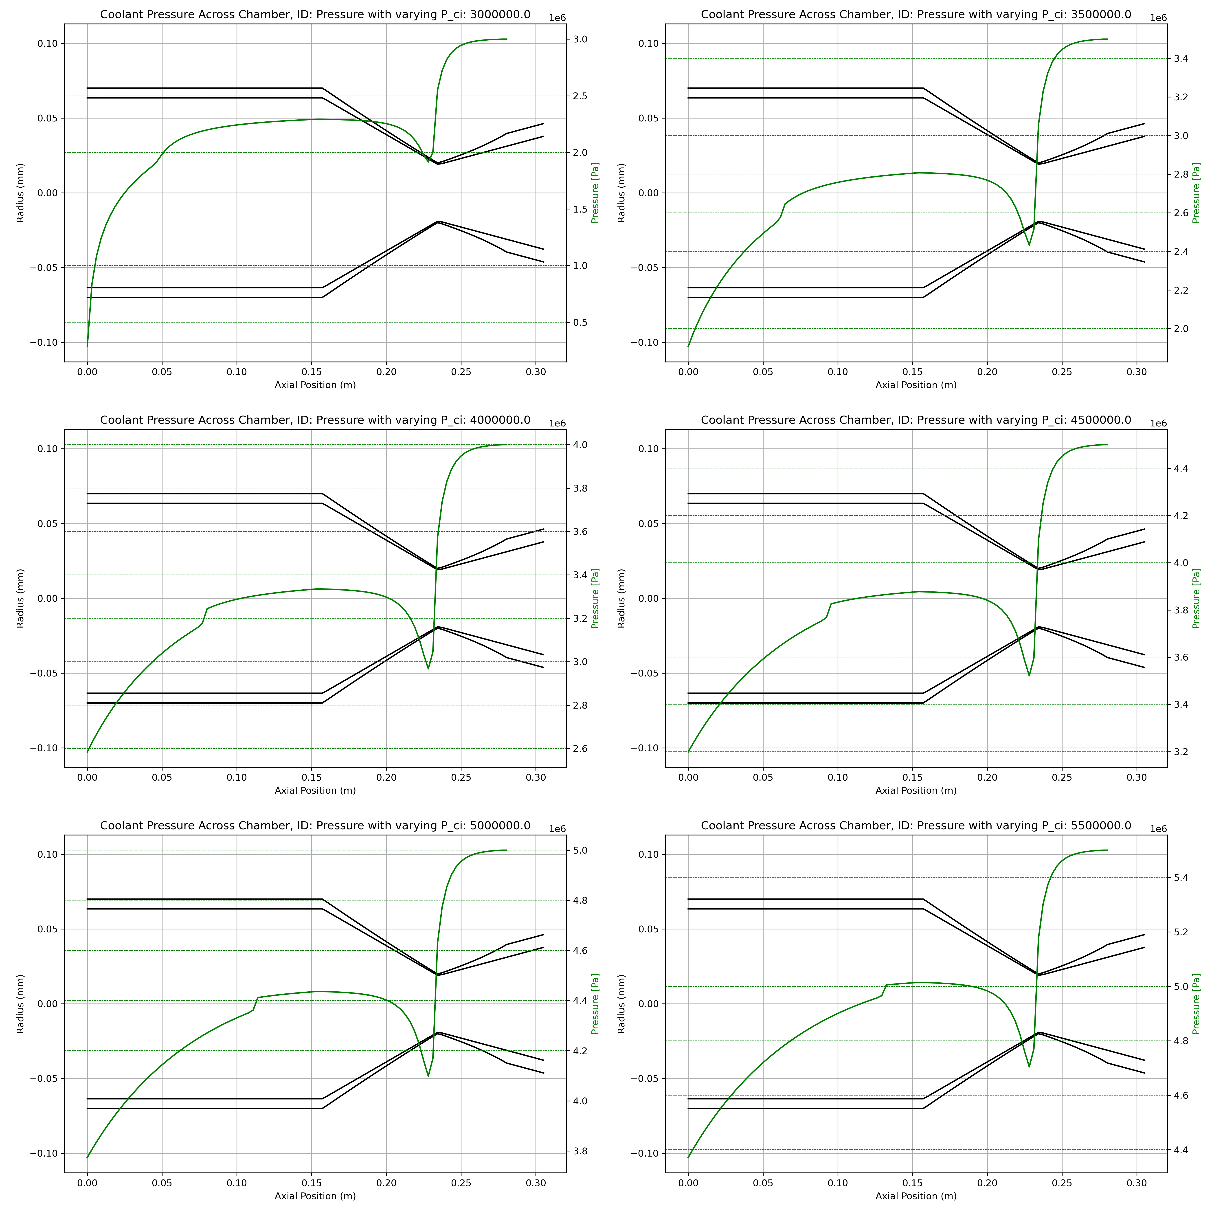
RegenSolver/solverplots/analysis/presvsP_ci.png
