Project-Liquid/TheRocket/RegenSolver/solverplots/analysis/velocityvsX_ci.png

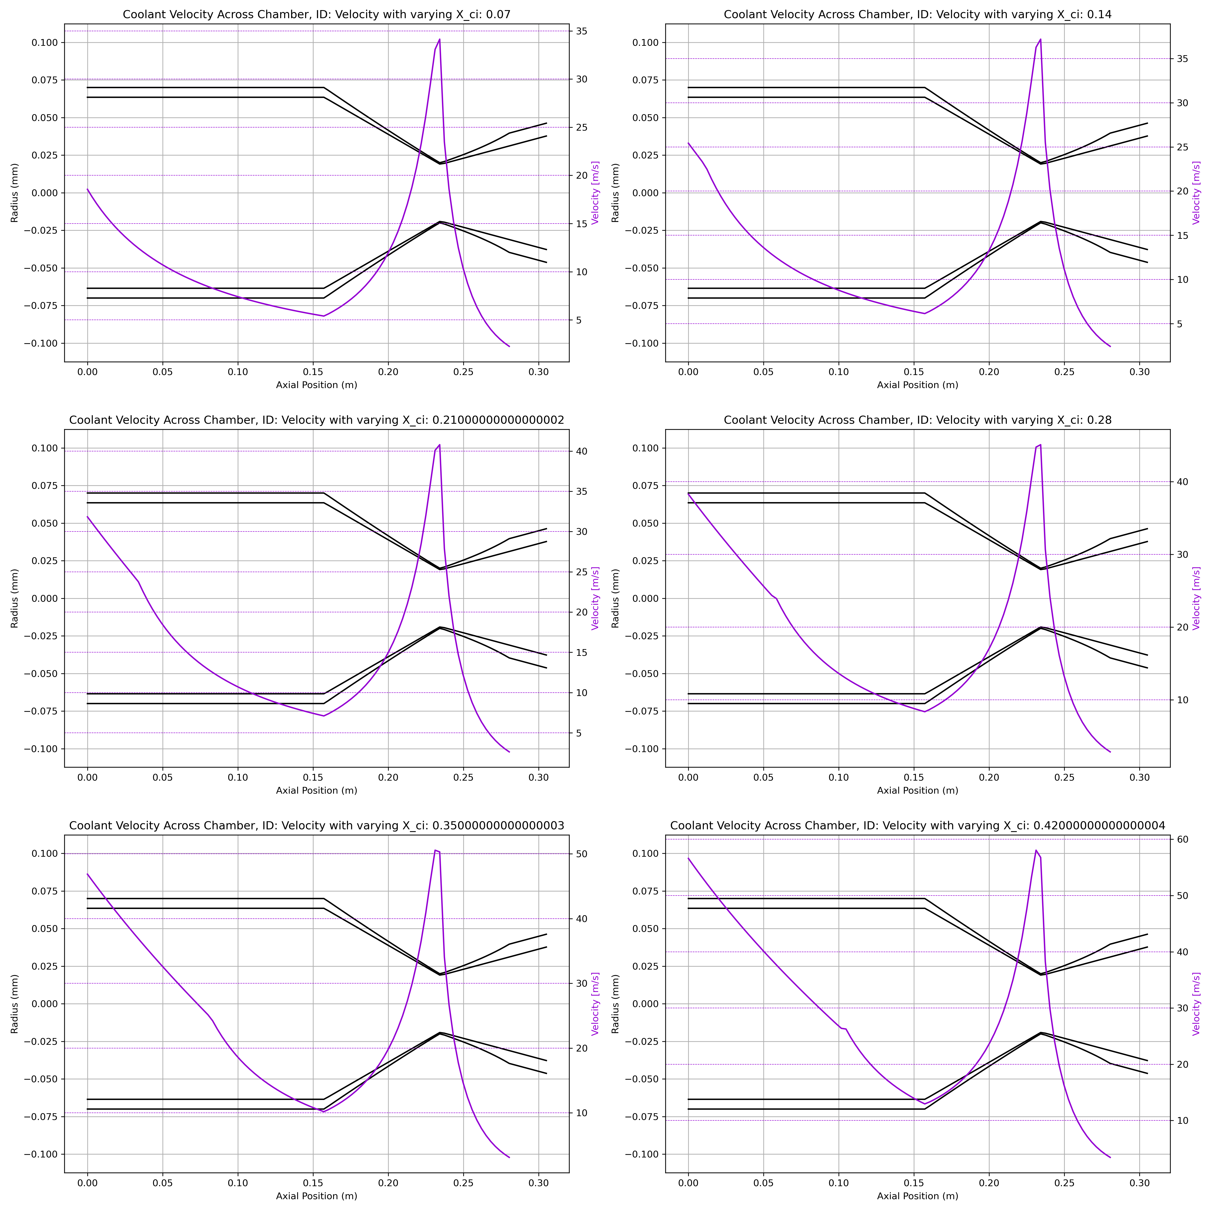
RegenSolver/solverplots/analysis/velocityvsX_ci.png
