Project-Liquid/TheRocket/RegenSolver/solverplots/analysis/velocityvsx_off.png

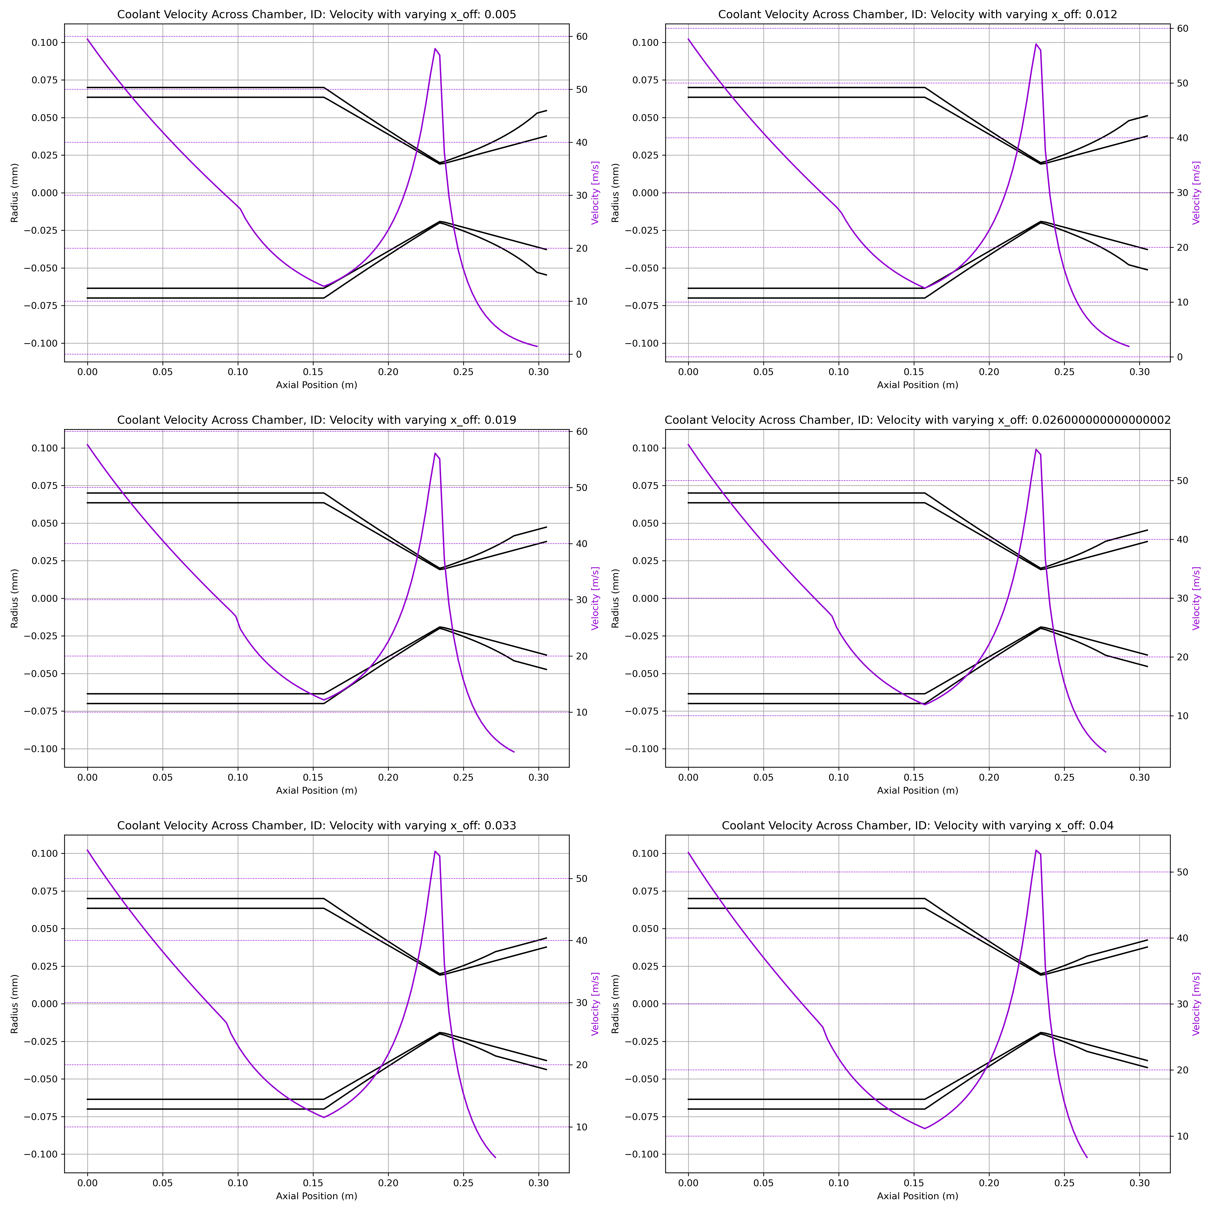
RegenSolver/solverplots/analysis/velocityvsx_off.png
