Project-Liquid/TheRocket/RegenSolver/solverplots/heatvsenginegeometry.png

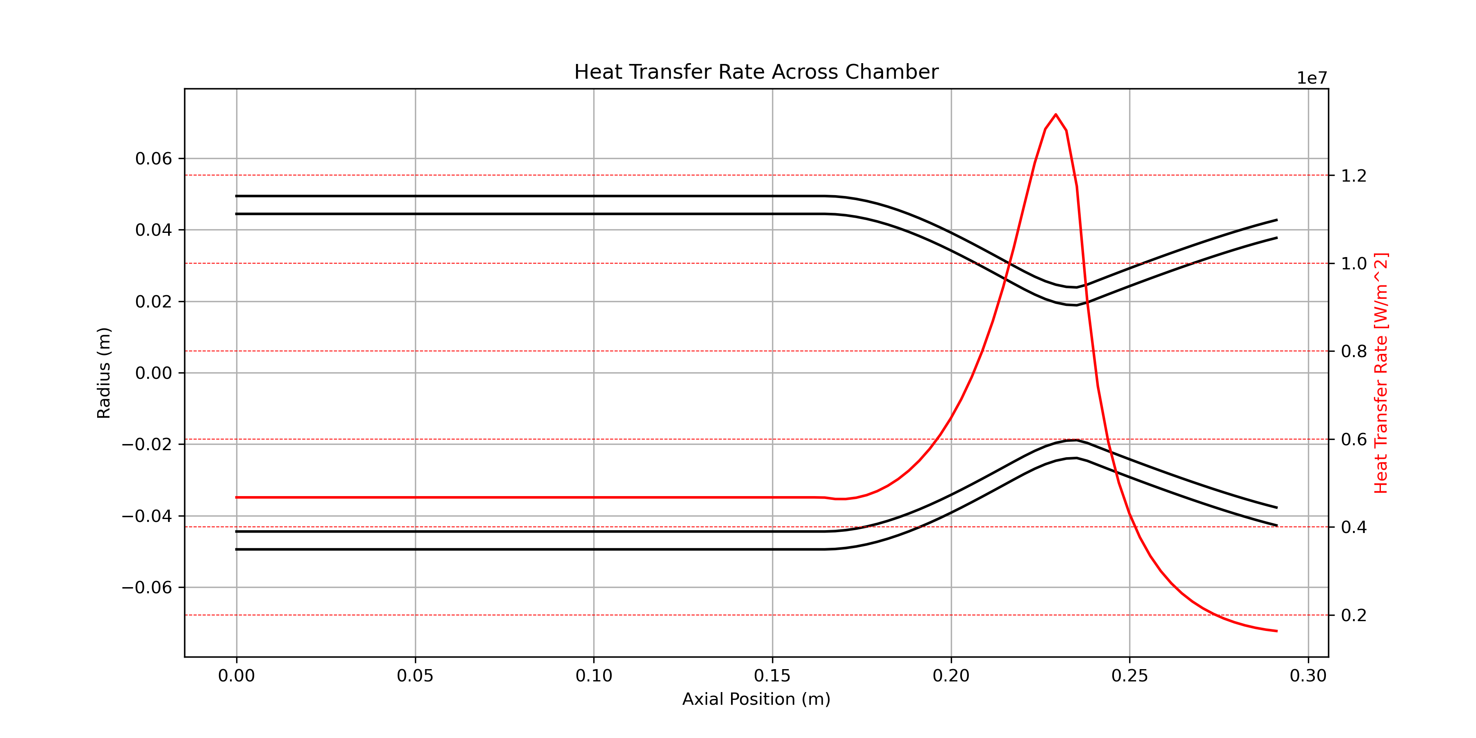
RegenSolver/solverplots/heatvsenginegeometry.png
