Project-Liquid/TheRocket/RegenSolver/solverplots/machvsenginegeometry.png

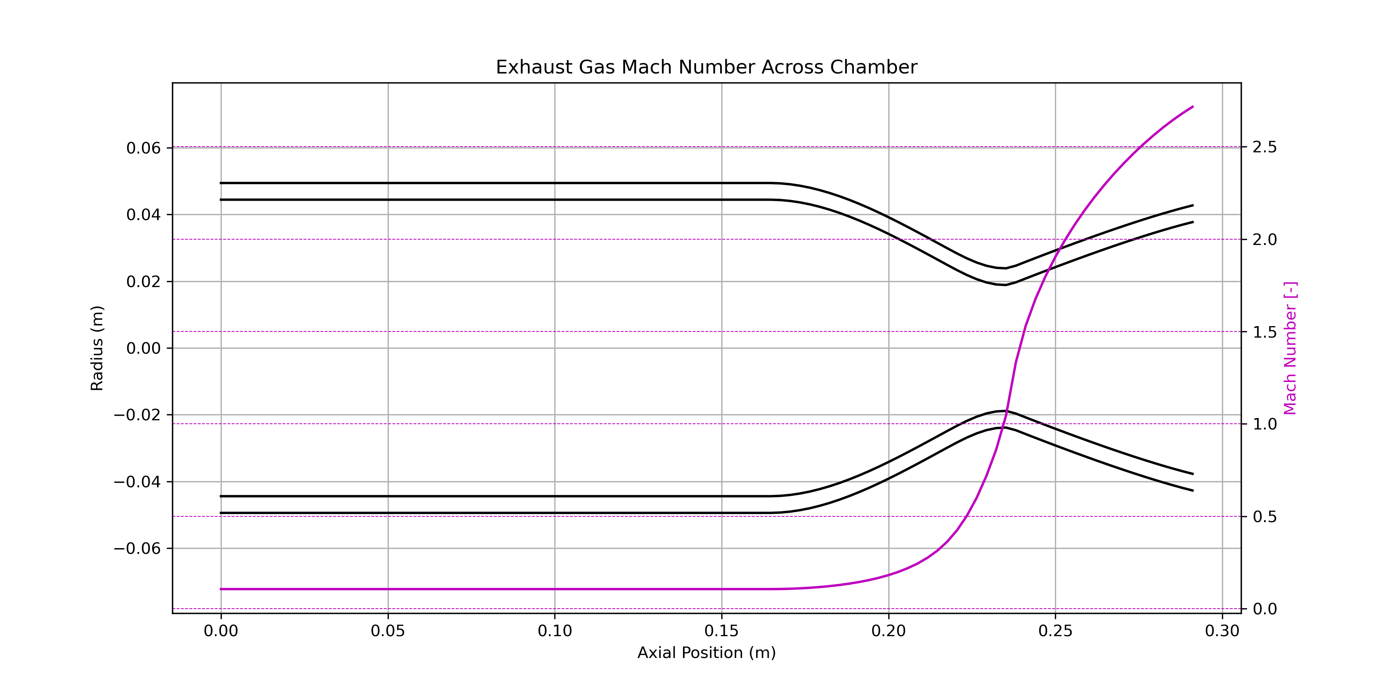
RegenSolver/solverplots/machvsenginegeometry.png
