Project-Liquid/TheRocket/RegenSolver/solverplots/saturatedenthalpy.png

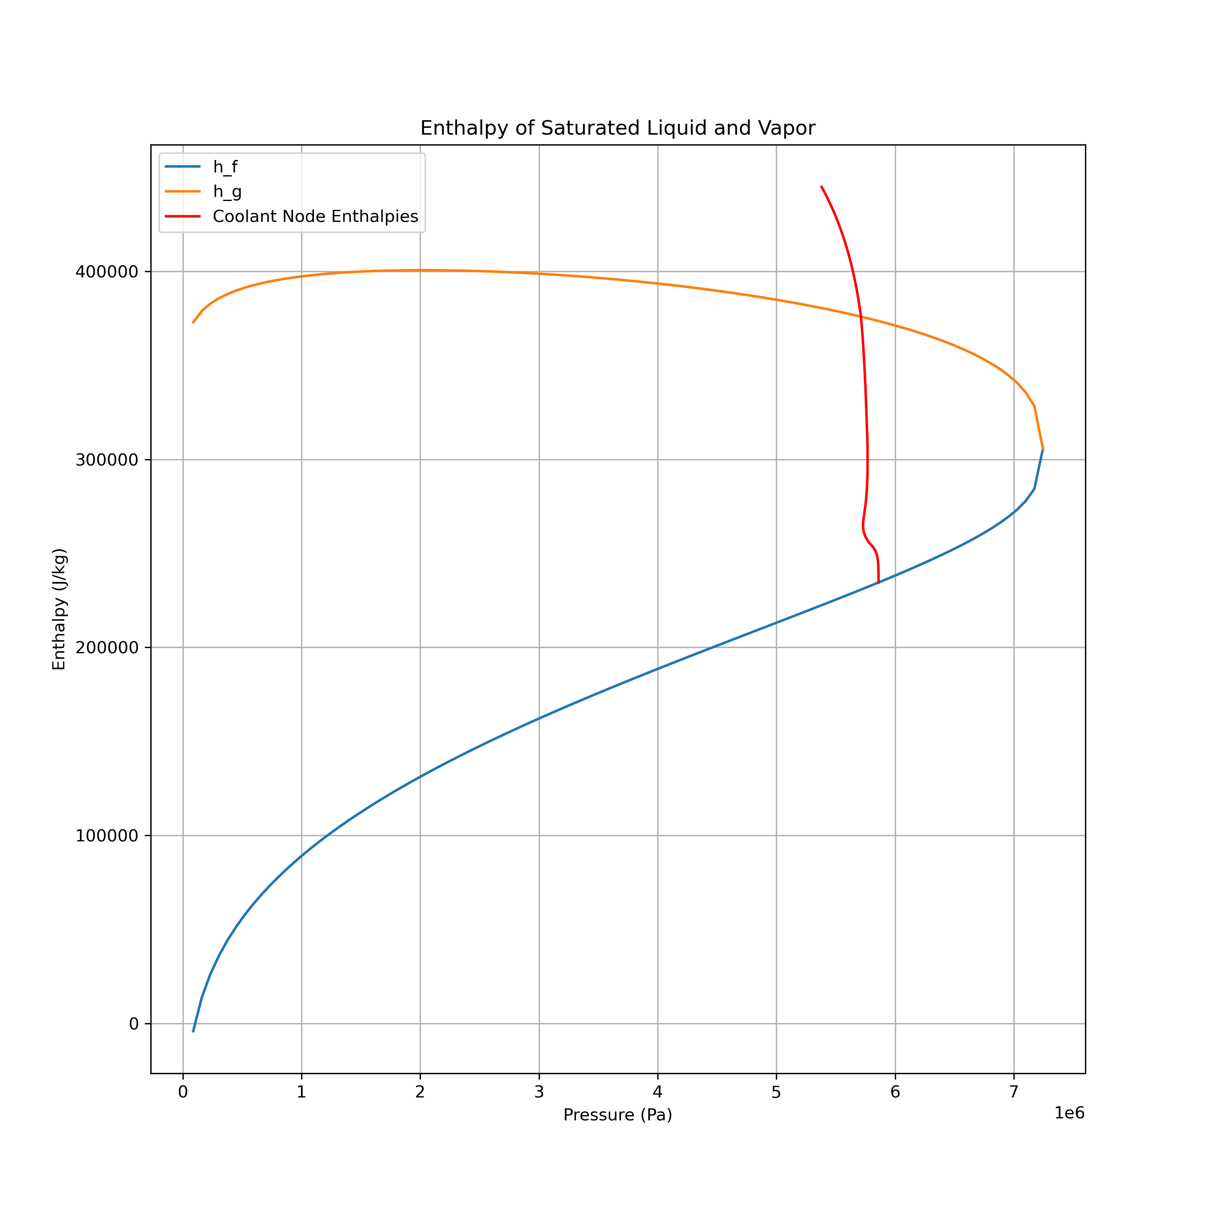
RegenSolver/solverplots/saturatedenthalpy.png
