Project-Liquid/TheRocket/RegenSolver/solverplots/solved/coolantreynolds.png

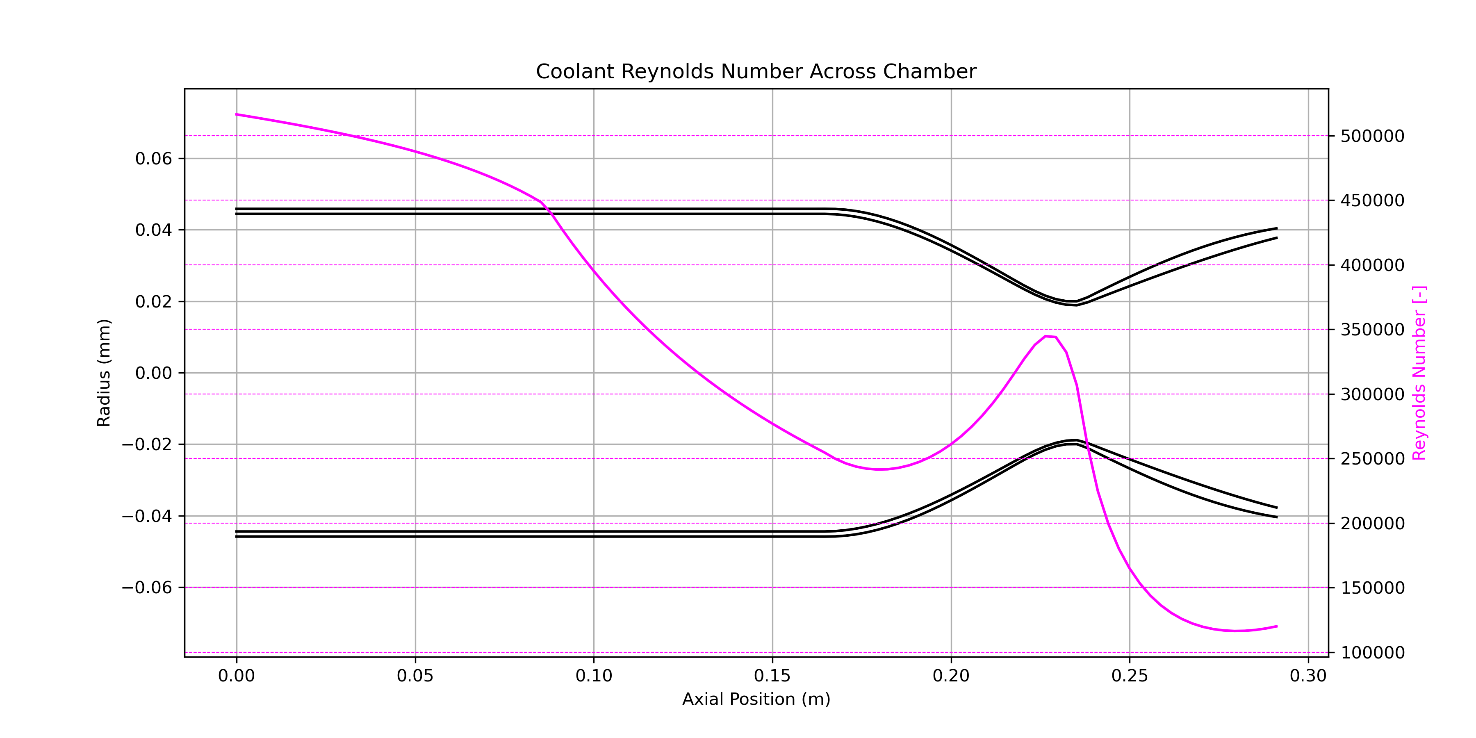
RegenSolver/solverplots/solved/coolantreynolds.png
