Project-Liquid/TheRocket/RegenSolver/solverplots/solved/coolantwallheight.png

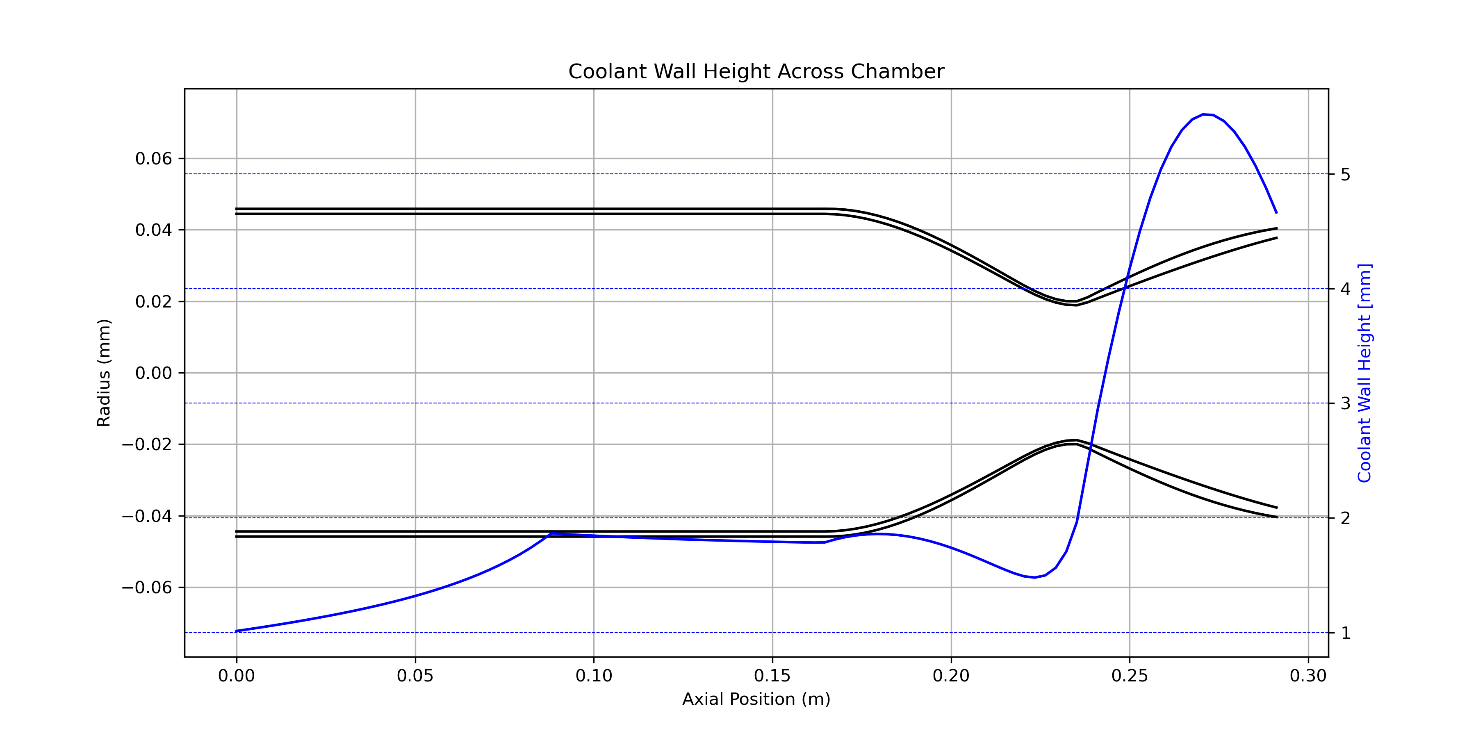
RegenSolver/solverplots/solved/coolantwallheight.png
