Project-Liquid/TheRocket/RegenSolver/solverplots/solved/fullchamber.png

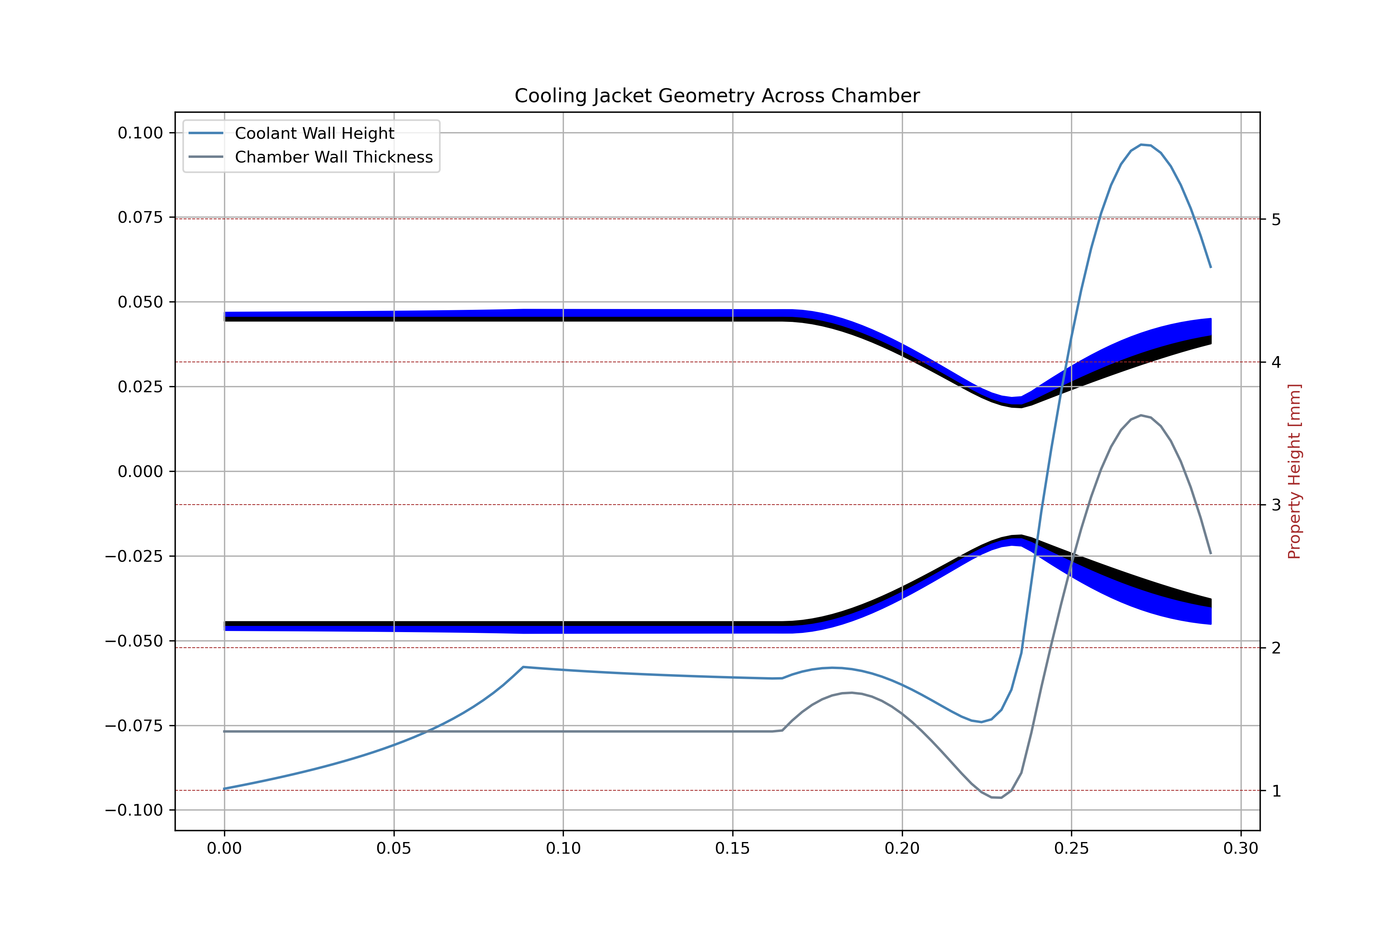
RegenSolver/solverplots/solved/fullchamber.png
