Project-Liquid/TheRocket/TheRocket/ThrustCurve.png

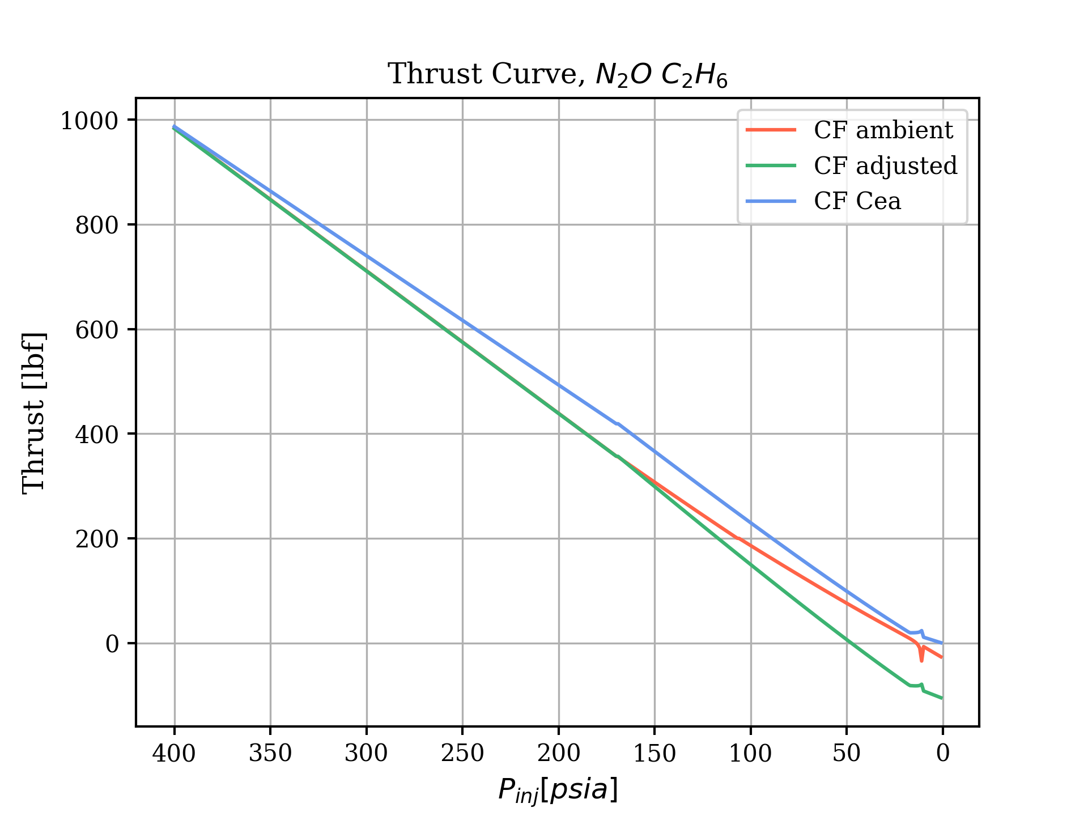
TheRocket/ThrustCurve.png
