Project-Liquid/TheRocket/(commit log)

2023-11-21 File Upload Test
    Added an excel file locally. Testing commit to shared github repo
    [MasterParameters.xlsx]
2023-11-22 Moving Files Around
    Test
    [MasterParameters.xlsx]
2023-11-22 Excel Pull
    Testing Matlab-Excel pull functionality. Simple pull function created and verified to work. Most immediate work:
    - Every MatLab input use this call function
    - Develop simple Python solver before expanding MatLab caller function
    - Expand both to allow more general excel file generation (if time allows)
    [MasterParameters.xlsx]
2023-11-23 Intermediate Changes
    [MasterParameters.xlsx]
2023-11-23 Excel Center
    Successfully changed both MatLab (engine) and Python (rocket) code to pull a majority of it's inputs from excel
    [MasterParameters.xlsx]
2023-11-27 OD Change Test
    Changed OD from 6 to 5"
    [MasterParameters.xlsx]
2023-11-27 Bay Size Changes
    AVbay changed from 5 to 12"
    Main Recovery changed from 22.5 to 18"
    Drogue bay changed from 10 to 6"
    [MasterParameters.xlsx]
2023-11-28 Add files via upload
    Liquid motor test
2023-11-29 Update
    Test update
    [MasterParameters.xlsx]
2023-11-30 Add Cantera Value Generation
    [exhaustgastandk.xlsx]
2023-12-01 All the Regen Solver Current Data
    Bamboo Final: Successful run of the Bamboo solver with an O/F of 5 and all the accompanying assumptions.
    Bamboo Solver (Stoic O/F): Same as Bamboo Final but with an O/F of 10.2 and all the accompanying assumptions + associated thrust curve.
    [ThrustCurve.csv]
2023-12-01 Updated Thrust Curve
    [Updated - ThrustCurve.csv]
2023-12-01 Thrust in freedom units
    [lbf - ThrustCurve.csv]
2023-12-01 Create Final Thrust Curve.csv
    [Final Thrust Curve.csv]
2023-12-01 Got rid of wrong thrust curves
    D
    [NThrustCurve.csv, ThrustCurve.csv, Updated - ThrustCurve.csv, lbf - ThrustCurve.csv]
2023-12-01 Changes demanded by the supreme rocket overlord Bryan Mcsmithers
    [ThrustCurve.csv]
2023-12-02 Random Changes for FAR OUT
    [Final Thrust Curve.csv, MasterParameters.xlsx, NThrustCurve.csv, ThrustCurve.csv, enginePressure.csv, fuelTankPressure.csv, oxTankPressure.csv, simplified_data.csv]
2023-12-02 Work on CoolProp and Cantera Comparison
    [exhaustgastandk.xlsx]
2023-12-02 Add Chamber Geometry Defining
2023-12-03 Change Specific Heat Ratios Used in Comparisons
2023-12-05 Add Node Functionality, Find T and P over Chamber
    [enginegeometry.csv, enginemassflow.csv, engineparameters.csv, engineparams.csv, nodedata.csv]
2023-12-10 Add Heat Transfer Rate Calculations
    [nodedata.csv]
2023-12-10 Restructure, Add Useful Heat Transfer Functions
2024-01-02 Begin Implementing Full Iteration Cycle
    Note: Because of Heat Flow Rate Q at cylindrical chamber section being modeled as 0 the iteration process currently breaks. Can fix this by either ending iteration at final node of nozzle (at least for wall thickness determination) or taking into account that Q at the cylindrical section is nonzero.
2024-01-03 Add Full Iteration Cycle and Result Plotting
    [nodedata.csv]
2024-01-19 Work on Coolant Property Research
    [enginegeometry.csv, enginemassflow.csv, engineparameters.csv, nodedata.csv]
2024-01-20 Update Geometry Export
    [enginegeometry.csv, enginegeometryverbal.csv, enginemassflow.csv, engineparameters.csv]
2024-01-25 Work on Coolant Analysis
    [nodedata.csv]
2024-01-26 Work on Coolant Properties
    [enginegeometry.csv, enginegeometryverbal.csv, enginemassflow.csv, engineparameters.csv]
2024-01-26 Add Area Calculations
    [enginegeometry.csv, enginegeometryverbal.csv, enginemassflow.csv, engineparameters.csv]
2024-01-26 Add Excel Saving
    [engineparameters.xlsx, solverdata.xlsx]
2024-01-28 Fix Typos, Update Coolant Properties in Liquid Model
    [engineparameters.xlsx, exhaustgastandk.xlsx, solverdata.xlsx]
2024-01-28 Add Vapor Quality Estimates
    [exhaustgastandk.xlsx, solverdata.xlsx]
2024-01-28 Look into Gas Solving
    [solverdata.xlsx]
2024-02-01 Init HEM Solver
    [solverdata.xlsx]
2024-02-02 Add Tapered Pipe Pressure Drop
    [solverdata.xlsx]
2024-02-03 Init Solver in Script Form
    [solverdata.xlsx]
2024-02-04 Update Coolant Superheated Vapor State Properties
    [enginegeometry.csv, enginegeometryverbal.csv, enginemassflow.csv, engineparameters.csv, engineparameters.xlsx, nodedata.csv, solverdata.xlsx]
2024-02-04 Implement Coolant Property Plotting
    [solverdata.xlsx]
2024-02-04 Look into Different Effects of Vapor Quality
    [engineparameters.xlsx, solverdata.xlsx, solverdatageometry.xlsx]
2024-02-09 Work on Script Version
    [solverdata.xlsx, solverdatageometry.xlsx]
2024-02-09 Check and Clean up Code
    [solverdata.xlsx, solverdatageometry.xlsx]
2024-02-09 Add Target Temperature Definition
    [solverdata.xlsx, solverdatageometry.xlsx]
2024-02-09 Variable Changes
    [MasterParameters.xlsx]
2024-02-12 GSE Tank Heater Module
2024-02-17 Add Linear Temperature Profile Definitions
    [solverdata.xlsx, solverdatageometry.xlsx]
2024-02-17 Add Critical Mass Flow Rate Estimation
    [solverdata.xlsx, solverdatageometry.xlsx]
2024-02-17 Recovery Change
    Exposed avionics bay length changed from 12" to 1"
    [MasterParameters.xlsx]
2024-02-17 Add Channel Width Exports
    [engineparameters.xlsx, solverdata.xlsx, solverdatageometry.xlsx]
2024-02-18 Add Outer Wall Diameter Outputs
    [engineparameters.xlsx, solverdata.xlsx, solverdatageometry.xlsx]
2024-02-24 GSE Heating Updates
2024-02-25 Init subsolver
    [channeltable.xlsx, solverdata.xlsx, solverdatageometry.xlsx]
2024-02-27 Init subsolvers
    [channeltable.xlsx, solverdata.xlsx, solverdatageometry.xlsx]
2024-02-28 Rocket Solver V2.0
    [dragCurve.csv, engine_thrust.csv, fuel_mass.csv, ox_mass.csv]
2024-02-28 Decluttering Engine Folder
    [ThrustCurve.csv, channeltable.xlsx, enginePressure.csv, enginegeometry.csv, enginegeometryverbal.csv, enginemassflow.csv, engineparameters.csv, engineparameters.xlsx]
2024-02-28 FAR-OUT CSV Section
    [FAR_CSV.csv]
2024-02-28 Init Subcooled Solver and File Directories
    [channeltable.xlsx, solverdata.xlsx, solverdatageometry.xlsx]
2024-03-02 Add spline geometry
    [BottomLeftCorner.csv, BottomRightCorner.csv, CenterWall.csv, TopLeftCorner.csv, TopRightCorner.csv, channeltable.xlsx, engineparameters.xlsx, nodedata.csv]
2024-03-02 Add Onshape CSV File Export
    [BottomLeftCorner2.csv, BottomRightCorner2.csv, CenterWall2.csv, TopLeftCorner2.csv, TopRightCorner2.csv]
2024-03-10 Add Inner and Outer Wall Curves
    [BottomLeftCorner2.csv, BottomRightCorner2.csv, CenterWall2.csv, InnerWall2.csv, OuterWall2.csv, TopLeftCorner2.csv, TopRightCorner2.csv, enginegeometry.csv]
2024-03-11 Update Wall Files
    [BottomLeftCorner.csv, BottomLeftCorner2.csv, BottomRightCorner.csv, BottomRightCorner2.csv, CenterWall.csv, CenterWall2.csv, InnerWall.csv, OuterWall.csv]
2024-03-14 Recovery framework
    Added layout for implementing recovery calculations into the code
2024-03-14 Revert "Recovery framework"
    This reverts commit 4671258beb119c4b3586c7fd6d3177c083b0af99.
2024-03-14 Revert "Merge branch 'main' of https://github.com/Project-Liquid/TheRocket"
    This reverts commit cdaa05bef08601f6ac46ec405f4c7452c3e1b349, reversing
    changes made to 93c2fb4b9ba7a2fcd88f1c0881b652017d45a85b.
    [BottomLeftCorner.csv, BottomRightCorner.csv, CenterWall.csv, FAR_CSV.csv, InnerWall.csv, MasterParameters.xlsx, OuterWall.csv, ThrustCurve.csv]
2024-03-15 Recovery Calculations I
    Initiated framework for recovery calculations.
2024-03-17 Recovery Calculations
    Added recovery code
    [MasterParameters.xlsx]
2024-03-19 Revert "Recovery Calculations"
    This reverts commit 5db538248e8ce4a75b1707768fbce41709f88c04.
    [MasterParameters.xlsx]
2024-03-20 Revert "Merge pull request #1 from Project-Liquid/main"
    This reverts commit 6bef87dd192712809a8ffb9b667e4e8d3c5fbe26, reversing
    changes made to 3a23b5860dc80085e7c564941fb7d16d8f26f3d8.
    [BottomLeftCorner.csv, BottomRightCorner.csv, CenterWall.csv, FAR_CSV.csv, InnerWall.csv, MasterParameters.xlsx, OuterWall.csv, ThrustCurve.csv]
2024-03-20 Set Constant Cylindrical Outer Wall Diameter
    [OuterWall.csv]
2024-04-06 Update Geometry Definitions
    [BottomLeftCorner.csv, BottomRightCorner.csv, CenterWall.csv, InnerWall.csv, OuterWall.csv, TopLeftCorner.csv, TopRightCorner.csv, channeltable.xlsx]
2024-04-07 PLOT_ON = True
    [BottomLeftCorner.csv, BottomRightCorner.csv, CenterWall.csv, InnerWall.csv, OuterWall.csv, TopLeftCorner.csv, TopRightCorner.csv, channeltable.xlsx]
2024-04-17 ASI Heater Update
2024-04-20 ASI Bottle Heater Updates
    Object oriented to store all variables of both the Ethane and Nitrous bottles, so the user doesn't need to manually change variables each time.
    Now the user only modifies the variables that count - h and ambient temp
2024-04-22 Tank Heater
    Finalizing Tank Heater for ASI
2024-04-29 Add Geometry Outputs
    [BottomLeftCorner.csv, BottomRightCorner.csv, CenterWall.csv, InnerWall.csv, OuterWall.csv, TopLeftCorner.csv, TopRightCorner.csv, channeltable.xlsx]
2024-10-28 read vars from excel sheet
    [variables.xlsx]
2024-10-28 Edits
    1) fixed `readVars` to assign variables rather than printing the table
    2) fixed "STRUCTURES2" to "STRUCTURES"
    [variables.xlsx]
2025-01-25 A couple months of changes
    [FAR_CSV.csv, engine_thrust.csv, fuel_mass.csv, ox_mass.csv, variables.xlsx]
2025-02-01 Updated Variables
    changes to the Recovery and Structures list
    [variables.xlsx]
2025-05-15 Added Rocket CEA Thrust Curve estimation
    [enginegeometry.csv, enginegeometryverbal.csv, engineparameters.csv, engineparameters.xlsx]
